iu3qez/hbr-8b/schematic/converted/bfo.kicad_sch

## KiCad design schematic/converted/bfo.kicad_sch (2026-09-16)

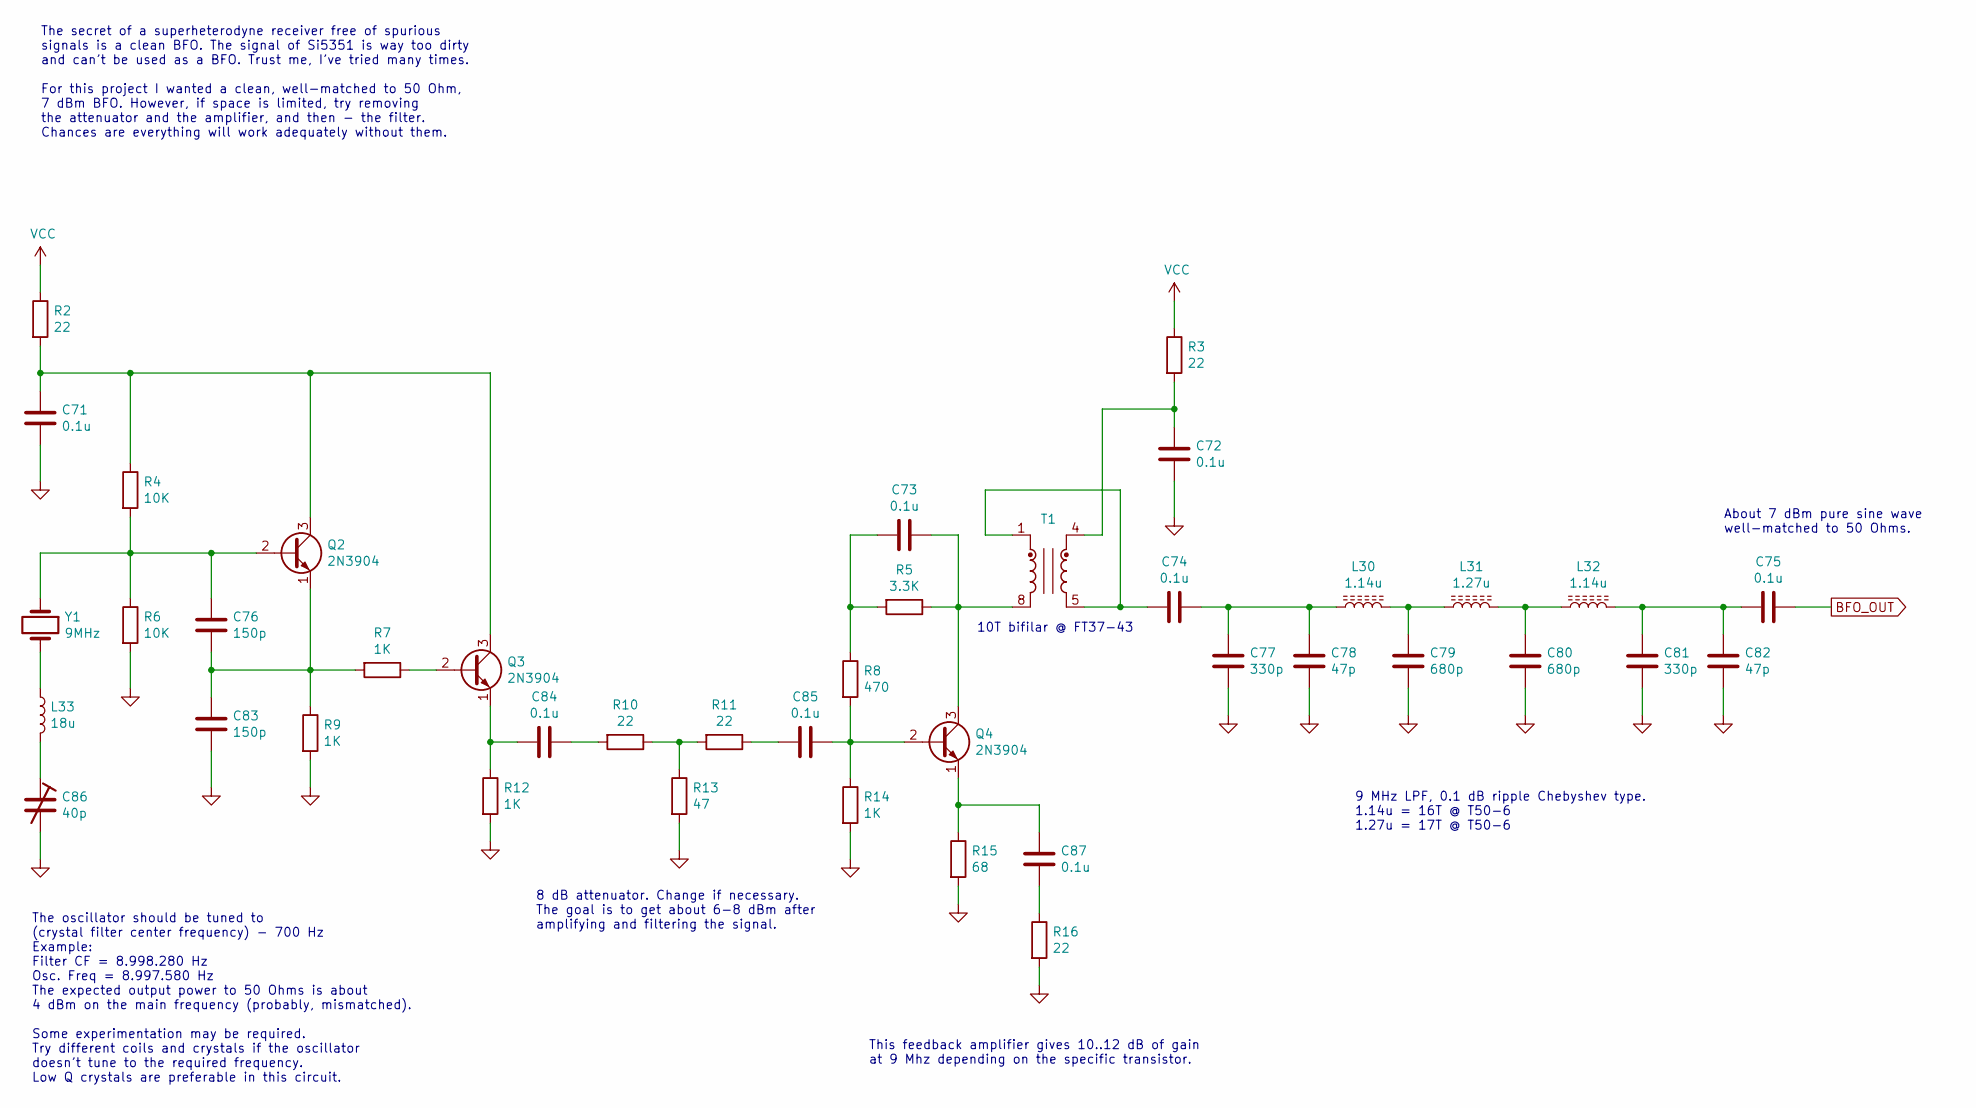
[picture p1: schematic bfo.kicad_sch]

Parts:
C71, C72, C73, C74, C75, C84, C85, C87: 0.1u
C76, C83: 150p
C77, C81: 330p
C78, C82: 47p
C79, C80: 680p
C86: 40p
L30, L32: 1.14u
L31: 1.27u
L33: 18u
Q2, Q3, Q4: 2N3904; TO-92_Inline
R2, R3, R10, R11, R16: 22
R4, R6: 10K
R5: 3.3K
R7, R9, R12, R14: 1K
R8: 470
R13: 47
R15: 68
T1: FT37-43; Pulse_PA2007NL
Y1: 9MHz

Connections:
BFO_OUT: C75.1
GND: C71.2, C72.2, C77.2, C78.2, C79.2, C80.2, C81.2, C82.2, C83.2, C86.2, R6.2, R9.2, R12.2, R13.2, R14.2, R15.2, R16.2
unnamed: C71.1, Q2.3 (C), Q3.3 (C), R2.2, R4.1
unnamed: C72.1, R3.2, T1.4
unnamed: C73.1, Q4.3 (C), R5.1, T1.8
unnamed: C73.2, R5.2, R8.1
unnamed: C74.1, C77.1, C78.1, L30.1
unnamed: C74.2, T1.1, T1.5
unnamed: C75.2, C81.1, C82.1, L32.2
unnamed: C76.1, Q2.2 (B), R4.2, R6.1, Y1.1
unnamed: C76.2, C83.1, Q2.1 (E), R7.2, R9.1
unnamed: C79.1, L30.2, L31.1
unnamed: C80.1, L31.2, L32.1
unnamed: C84.1, R10.2
unnamed: C84.2, Q3.1 (E), R12.1
unnamed: C85.1, Q4.2 (B), R8.2, R14.1
unnamed: C85.2, R11.1
unnamed: C86.1, L33.2
unnamed: C87.1, Q4.1 (E), R15.1
unnamed: C87.2, R16.1
unnamed: L33.1, Y1.2
unnamed: Q3.2 (B), R7.1
unnamed: R10.1, R11.2, R13.1
VCC: R2.1, R3.1

Notes on the sheet:
The oscillator should be tuned to (crystal filter center frequency) - 700 Hz Example: Filter CF = 8.998.280 Hz Osc. Freq = 8.997.580 Hz The expected output power to 50 Ohms is about 4 dBm on the main frequency (probably, mismatched). Some experimentation may be required. Try different coils and cry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
This feedback amplifier gives 10..12 dB of gain at 9 Mhz depending on the specific transistor.
8 dB attenuator. Change if necessary. The goal is to get about 6-8 dBm after amplifying and filtering the signal.
The secret of a superheterodyne receiver free of spurious signals is a clean BFO. The signal of Si5351 is way too dirty and can’t be used as a BFO. Trust me, I’ve tried many times. For this project I wanted a clean, well-matched to 50 Ohm, 7 dBm BFO. However, if space is limited, try removing the a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
About 7 dBm pure sine wave well-matched to 50 Ohms.
9 MHz LPF, 0.1 dB ripple Chebyshev type. 1.14u = 16T @ T50-6 1.27u = 17T @ T50-6
10T bifilar @ FT37-43
