iu3qez/hbr-8b/schematic/converted/bpf-relays-1.kicad_sch

## KiCad design schematic/converted/bpf-relays-1.kicad_sch (2026-09-16)

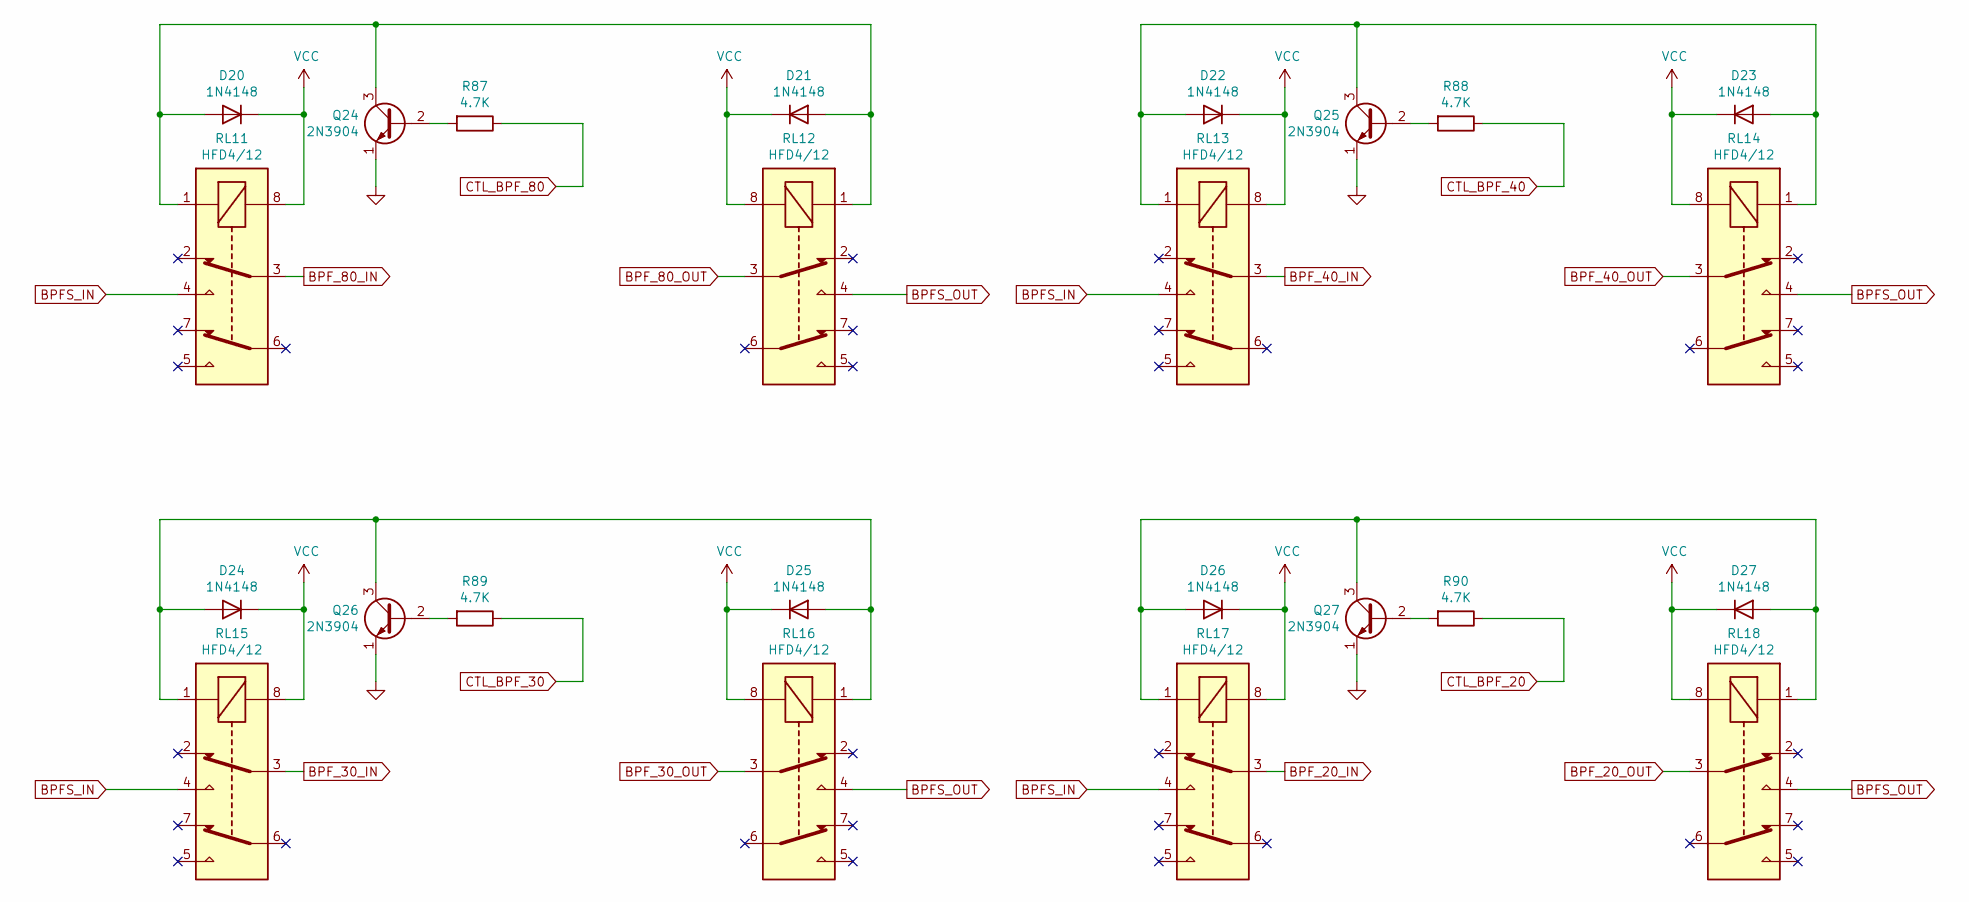
[picture p2: schematic bpf-relays-1.kicad_sch]

Parts:
D20, D21, D22, D23, D24, D25, D26, D27: 1N4148; D_DO-41_SOD81_P10.16mm_Horizontal
Q24, Q25, Q26, Q27: 2N3904; TO-92_Inline
R87, R88, R89, R90: 4.7K
RL11, RL12, RL13, RL14, RL15, RL16, RL17, RL18: HFD4/12; Relay_DPDT_Omron_G2RL

Connections:
BPFS_IN: RL11.4, RL13.4, RL15.4, RL17.4
BPFS_OUT: RL12.4, RL14.4, RL16.4, RL18.4
BPF_20_IN: RL17.3
BPF_20_OUT: RL18.3
BPF_30_IN: RL15.3
BPF_30_OUT: RL16.3
BPF_40_IN: RL13.3
BPF_40_OUT: RL14.3
BPF_80_IN: RL11.3
BPF_80_OUT: RL12.3
CTL_BPF_20: R90.1
CTL_BPF_30: R89.1
CTL_BPF_40: R88.1
CTL_BPF_80: R87.1
GND: Q24.1 (E), Q25.1 (E), Q26.1 (E), Q27.1 (E)
unnamed: D20.2 (A), D21.2 (A), Q24.3 (C), RL11.1, RL12.1
unnamed: D22.2 (A), D23.2 (A), Q25.3 (C), RL13.1, RL14.1
unnamed: D24.2 (A), D25.2 (A), Q26.3 (C), RL15.1, RL16.1
unnamed: D26.2 (A), D27.2 (A), Q27.3 (C), RL17.1, RL18.1
unnamed: Q24.2 (B), R87.2
unnamed: Q25.2 (B), R88.2
unnamed: Q26.2 (B), R89.2
unnamed: Q27.2 (B), R90.2
VCC: D20.1 (K), D21.1 (K), D22.1 (K), D23.1 (K), D24.1 (K), D25.1 (K), D26.1 (K), D27.1 (K), RL11.8, RL12.8, RL13.8, RL14.8, RL15.8, RL16.8, RL17.8, RL18.8
