iu3qez/hbr-8b/schematic/converted/bpf-relays-2.kicad_sch

## KiCad design schematic/converted/bpf-relays-2.kicad_sch (2026-09-16)

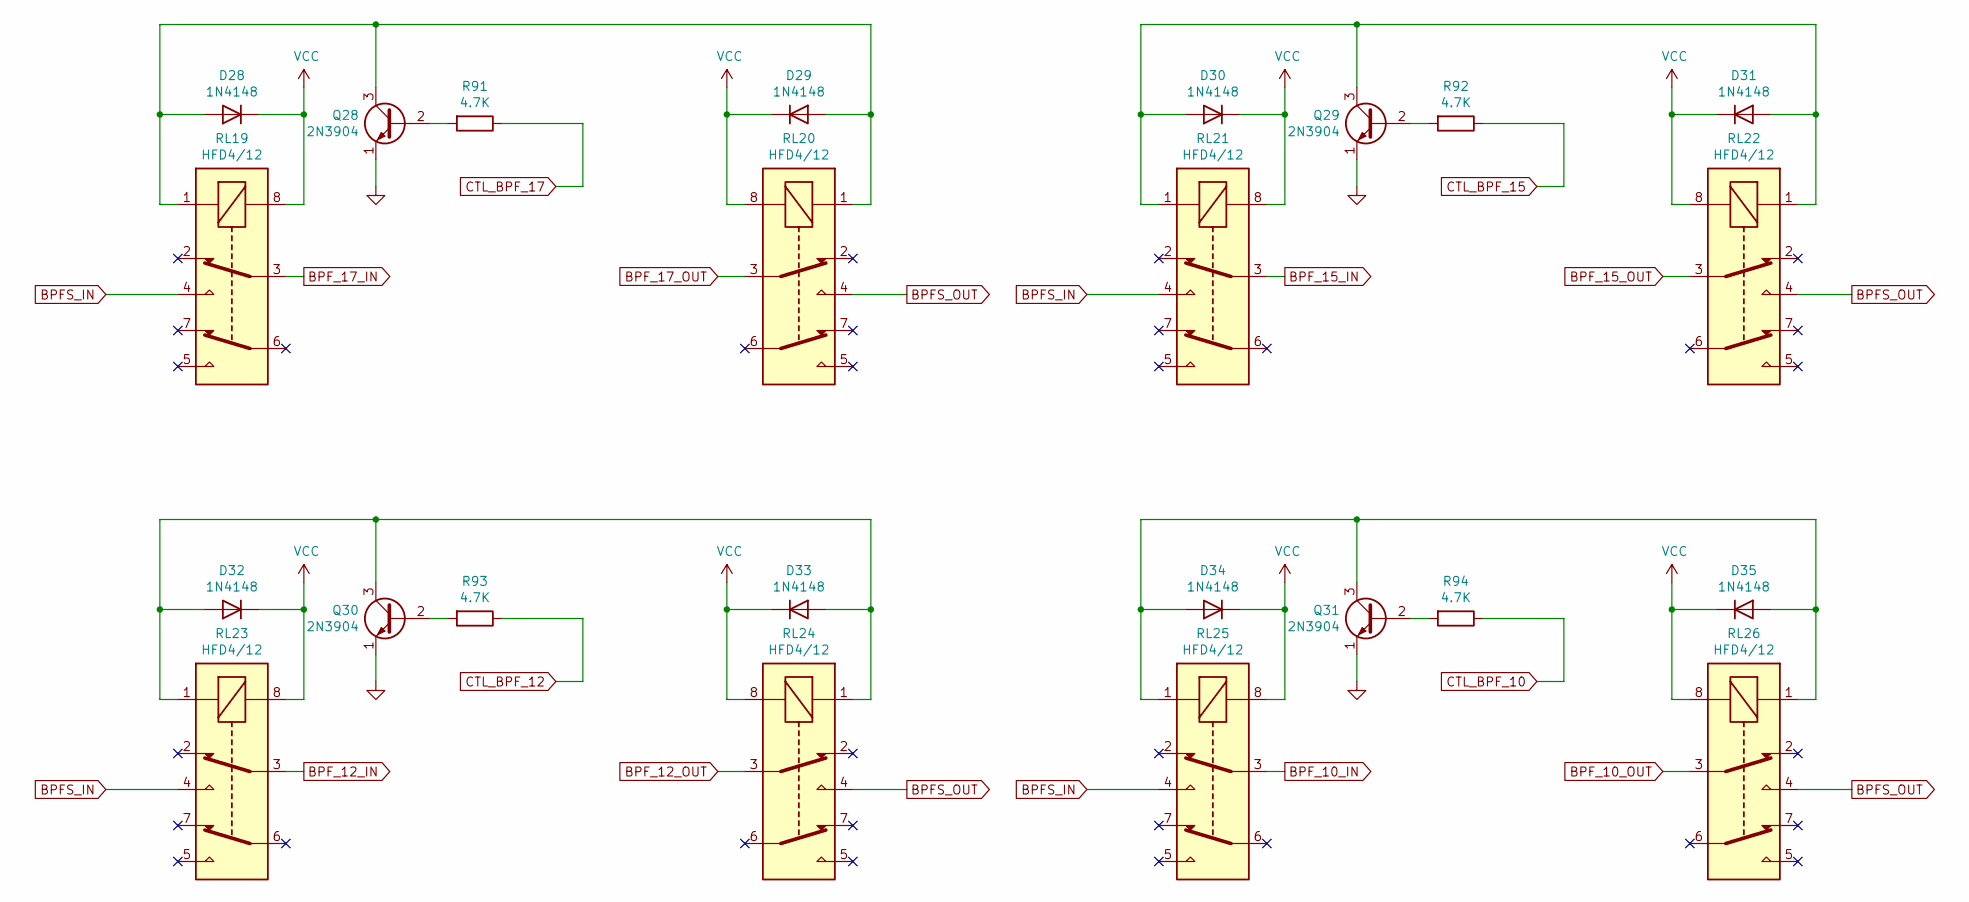
[picture p3: schematic bpf-relays-2.kicad_sch]

Parts:
D28, D29, D30, D31, D32, D33, D34, D35: 1N4148; D_DO-41_SOD81_P10.16mm_Horizontal
Q28, Q29, Q30, Q31: 2N3904; TO-92_Inline
R91, R92, R93, R94: 4.7K
RL19, RL20, RL21, RL22, RL23, RL24, RL25, RL26: HFD4/12; Relay_DPDT_Omron_G2RL

Connections:
BPFS_IN: RL19.4, RL21.4, RL23.4, RL25.4
BPFS_OUT: RL20.4, RL22.4, RL24.4, RL26.4
BPF_10_IN: RL25.3
BPF_10_OUT: RL26.3
BPF_12_IN: RL23.3
BPF_12_OUT: RL24.3
BPF_15_IN: RL21.3
BPF_15_OUT: RL22.3
BPF_17_IN: RL19.3
BPF_17_OUT: RL20.3
CTL_BPF_10: R94.1
CTL_BPF_12: R93.1
CTL_BPF_15: R92.1
CTL_BPF_17: R91.1
GND: Q28.1 (E), Q29.1 (E), Q30.1 (E), Q31.1 (E)
unnamed: D28.2 (A), D29.2 (A), Q28.3 (C), RL19.1, RL20.1
unnamed: D30.2 (A), D31.2 (A), Q29.3 (C), RL21.1, RL22.1
unnamed: D32.2 (A), D33.2 (A), Q30.3 (C), RL23.1, RL24.1
unnamed: D34.2 (A), D35.2 (A), Q31.3 (C), RL25.1, RL26.1
unnamed: Q28.2 (B), R91.2
unnamed: Q29.2 (B), R92.2
unnamed: Q30.2 (B), R93.2
unnamed: Q31.2 (B), R94.2
VCC: D28.1 (K), D29.1 (K), D30.1 (K), D31.1 (K), D32.1 (K), D33.1 (K), D34.1 (K), D35.1 (K), RL19.8, RL20.8, RL21.8, RL22.8, RL23.8, RL24.8, RL25.8, RL26.8
