iu3qez/hbr-8b/schematic/converted/bpfs.kicad_sch

## KiCad design schematic/converted/bpfs.kicad_sch (2026-09-16)

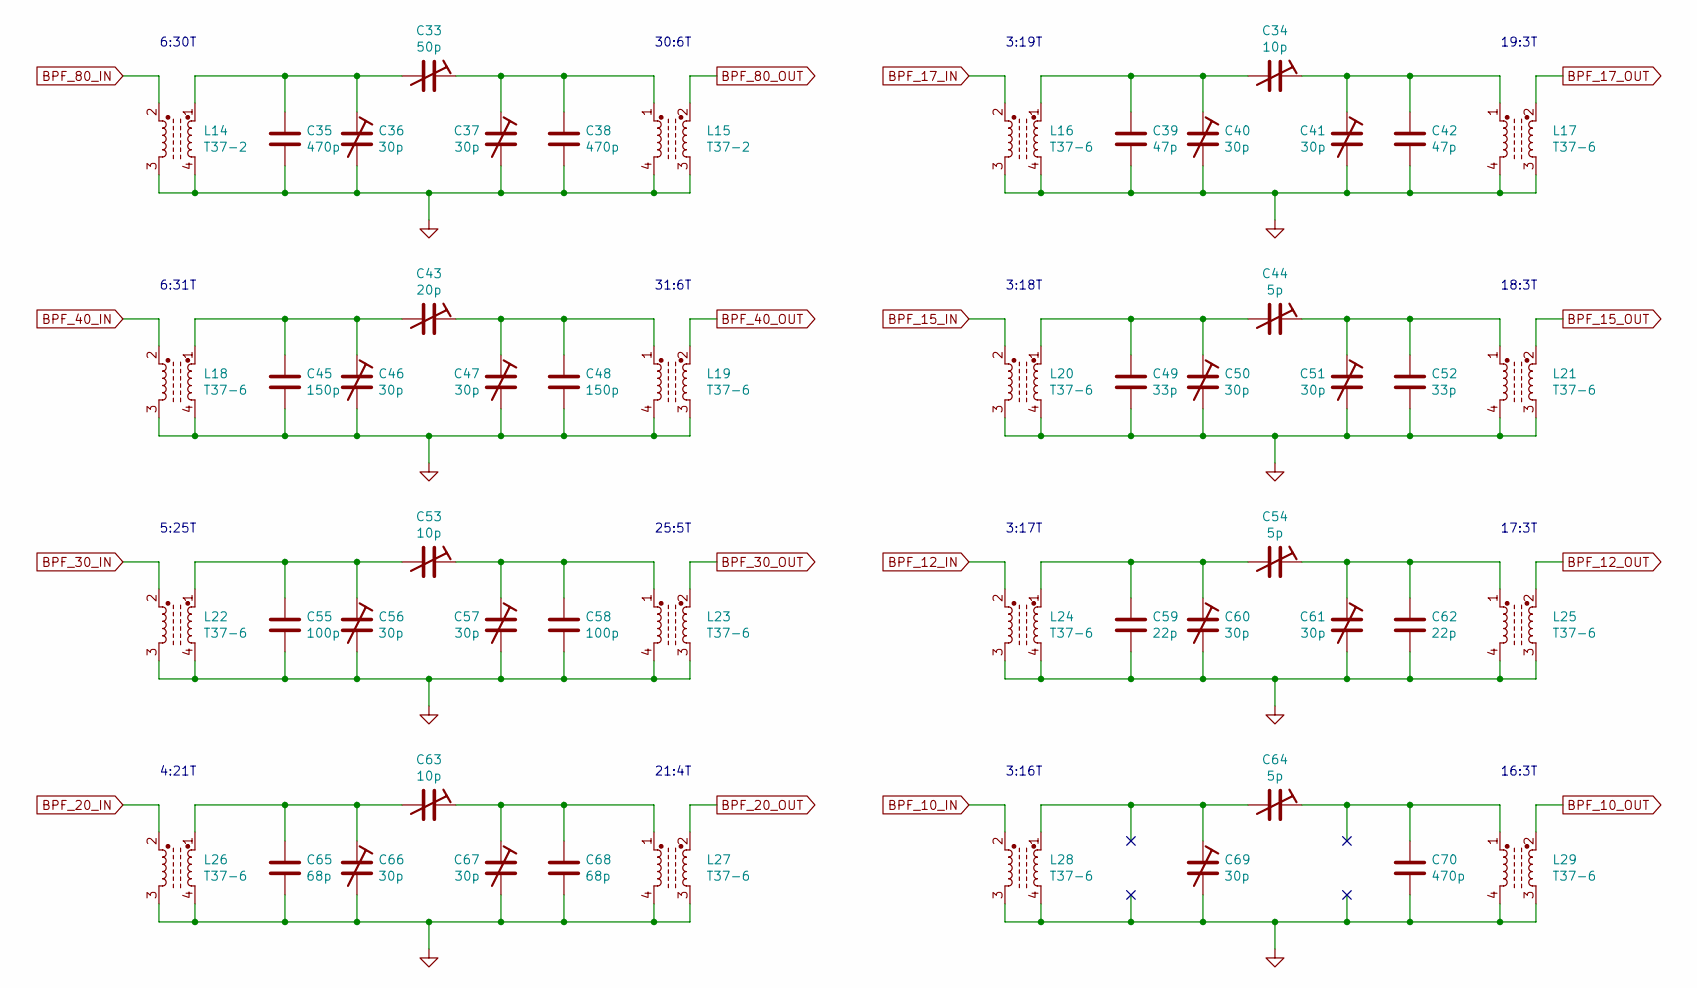
[picture p4: schematic bpfs.kicad_sch]

Parts:
C33: 50p
C34, C53, C63: 10p
C35, C38, C70: 470p
C36, C37, C40, C41, C46, C47, C50, C51, C56, C57, C60, C61, C66, C67, C69: 30p
C39, C42: 47p
C43: 20p
C44, C54, C64: 5p
C45, C48: 150p
C49, C52: 33p
C55, C58: 100p
C59, C62: 22p
C65, C68: 68p
L14, L15: T37-2
L16, L17, L18, L19, L20, L21, L22, L23, L24, L25, L26, L27, L28, L29: T37-6

Connections:
BPF_10_IN: L28.2
BPF_10_OUT: L29.2
BPF_12_IN: L24.2
BPF_12_OUT: L25.2
BPF_15_IN: L20.2
BPF_15_OUT: L21.2
BPF_17_IN: L16.2
BPF_17_OUT: L17.2
BPF_20_IN: L26.2
BPF_20_OUT: L27.2
BPF_30_IN: L22.2
BPF_30_OUT: L23.2
BPF_40_IN: L18.2
BPF_40_OUT: L19.2
BPF_80_IN: L14.2
BPF_80_OUT: L15.2
GND: C35.2, C36.2, C37.2, C38.2, C39.2, C40.2, C41.2, C42.2, C45.2, C46.2, C47.2, C48.2, C49.2, C50.2, C51.2, C52.2, C55.2, C56.2, C57.2, C58.2, C59.2, C60.2, C61.2, C62.2, C65.2, C66.2, C67.2, C68.2, C69.2, C70.2, L14.3, L14.4, L15.3, L15.4, L16.3, L16.4, L17.3, L17.4, L18.3, L18.4, L19.3, L19.4, L20.3, L20.4, L21.3, L21.4, L22.3, L22.4, L23.3, L23.4, L24.3, L24.4, L25.3, L25.4, L26.3, L26.4, L27.3, L27.4, L28.3, L28.4, L29.3, L29.4
unnamed: C33.1, C37.1, C38.1, L15.1
unnamed: C33.2, C35.1, C36.1, L14.1
unnamed: C34.1, C41.1, C42.1, L17.1
unnamed: C34.2, C39.1, C40.1, L16.1
unnamed: C43.1, C47.1, C48.1, L19.1
unnamed: C43.2, C45.1, C46.1, L18.1
unnamed: C44.1, C51.1, C52.1, L21.1
unnamed: C44.2, C49.1, C50.1, L20.1
unnamed: C53.1, C57.1, C58.1, L23.1
unnamed: C53.2, C55.1, C56.1, L22.1
unnamed: C54.1, C61.1, C62.1, L25.1
unnamed: C54.2, C59.1, C60.1, L24.1
unnamed: C63.1, C67.1, C68.1, L27.1
unnamed: C63.2, C65.1, C66.1, L26.1
unnamed: C64.1, C70.1, L29.1
unnamed: C64.2, C69.1, L28.1

Notes on the sheet:
18:3T
21:4T
30:6T
3:19T
6:30T
3:16T
3:17T
6:31T
17:3T
16:3T
5:25T
25:5T
4:21T
19:3T
3:18T
31:6T
