iu3qez/hbr-8b/schematic/converted/cw-tone.kicad_sch

## KiCad design schematic/converted/cw-tone.kicad_sch (2026-09-16)

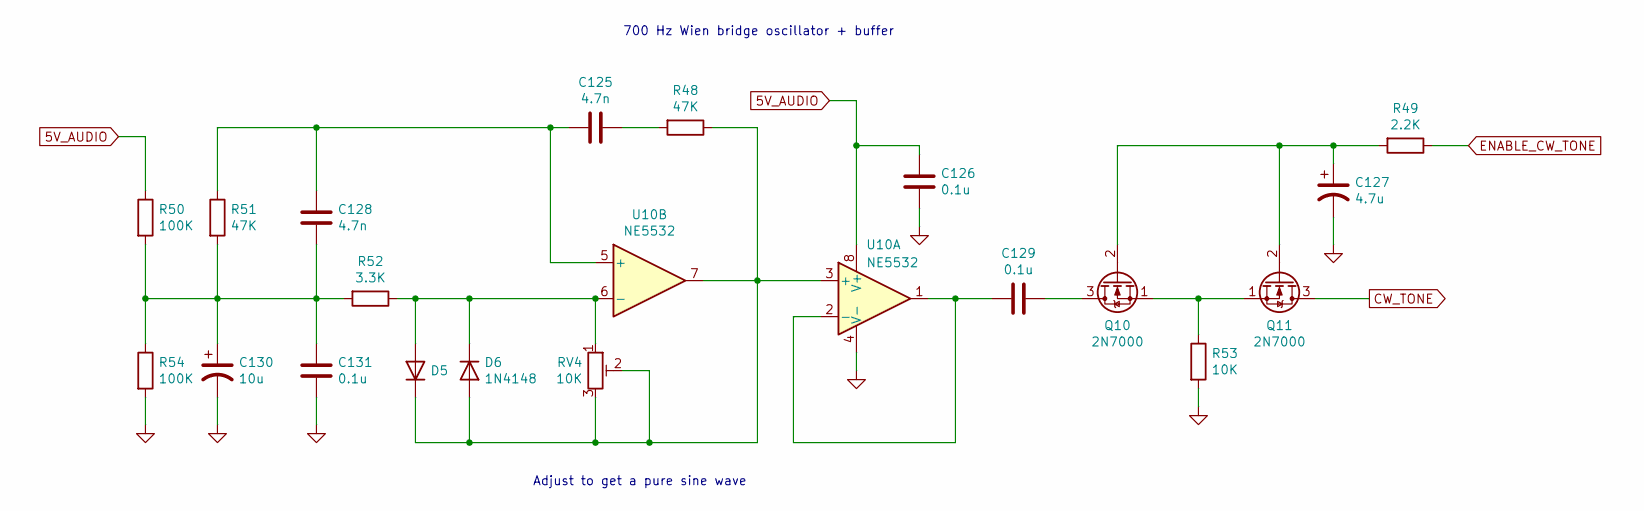
[picture p5: schematic cw-tone.kicad_sch]

Parts:
C125, C128: 4.7n
C126, C129, C131: 0.1u
C127: 4.7u
C130: 10u
D5, D6: 1N4148; D_DO-35_SOD27_P7.62mm_Horizontal
Q10, Q11: 2N7000; TO-92_Inline
R48, R51: 47K
R49: 2.2K
R50, R54: 100K
R52: 3.3K
R53: 10K
RV4: 10K
U10: NE5532

Connections:
5V_AUDIO: C126.1, R50.1, U10.8 (V+)
CW_TONE: Q11.3 (D)
ENABLE_CW_TONE: R49.1
GND: C126.2, C127.2, C130.2, C131.2, R53.2, R54.2, U10.4 (V-)
unnamed: C125.1, R48.2
unnamed: C125.2, C128.1, R51.1, U10.5 (+)
unnamed: C127.1, Q10.2 (G), Q11.2 (G), R49.2
unnamed: C128.2, C130.1, C131.1, R50.2, R51.2, R52.2, R54.1
unnamed: C129.1, Q10.3 (D)
unnamed: C129.2, U10.1, U10.2 (-)
unnamed: D5.1 (K), D6.2 (A), R48.1, RV4.2, RV4.3, U10.3 (+), U10.7
unnamed: D5.2 (A), D6.1 (K), R52.1, RV4.1, U10.6 (-)
unnamed: Q10.1 (S), Q11.1 (S), R53.1

Notes on the sheet:
Adjust to get a pure sine wave
700 Hz Wien bridge oscillator + buffer
