iu3qez/hbr-8b/schematic/converted/extra-rx-filters.kicad_sch

## KiCad design schematic/converted/extra-rx-filters.kicad_sch (2026-09-16)

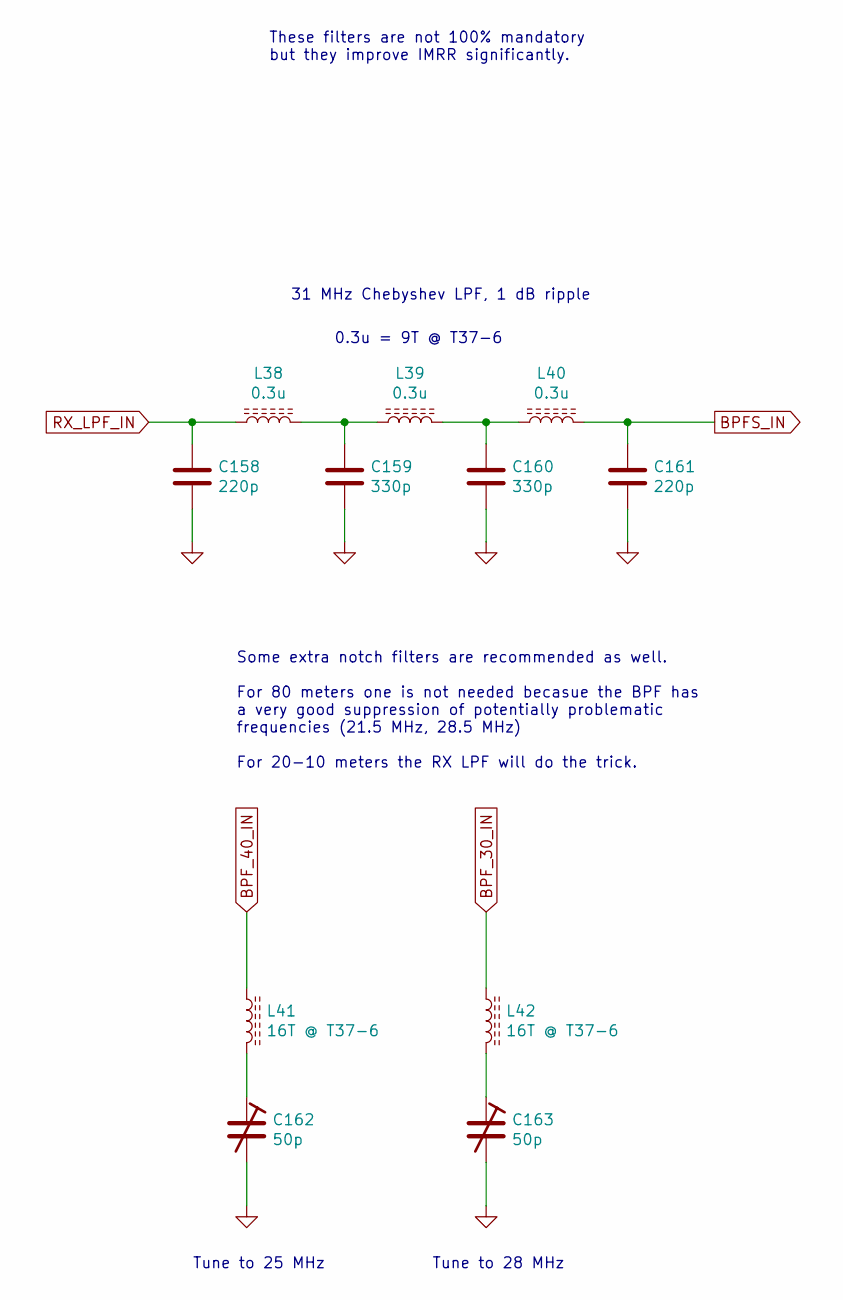
[picture p6: schematic extra-rx-filters.kicad_sch]

Parts:
C158, C161: 220p
C159, C160: 330p
C162, C163: 50p
L38, L39, L40: 0.3u
L41, L42: 16T @ T37-6

Connections:
BPFS_IN: C161.1, L40.2
BPF_30_IN: L42.1
BPF_40_IN: L41.1
GND: C158.2, C159.2, C160.2, C161.2, C162.2, C163.2
unnamed: C159.1, L38.2, L39.1
unnamed: C160.1, L39.2, L40.1
unnamed: C162.1, L41.2
unnamed: C163.1, L42.2
RX_LPF_IN: C158.1, L38.1

Notes on the sheet:
Tune to 28 MHz
These filters are not 100% mandatory but they improve IMRR significantly.
31 MHz Chebyshev LPF, 1 dB ripple
Tune to 25 MHz
Some extra notch filters are recommended as well. For 80 meters one is not needed becasue the BPF has a very good suppression of potentially problematic frequencies (21.5 MHz, 28.5 MHz) For 20-10 meters the RX LPF will do the trick.
0.3u = 9T @ T37-6
