iu3qez/hbr-8b/schematic/converted/hbr-8b.kicad_sch

## KiCad design schematic/converted/hbr-8b.kicad_sch (2026-09-16)

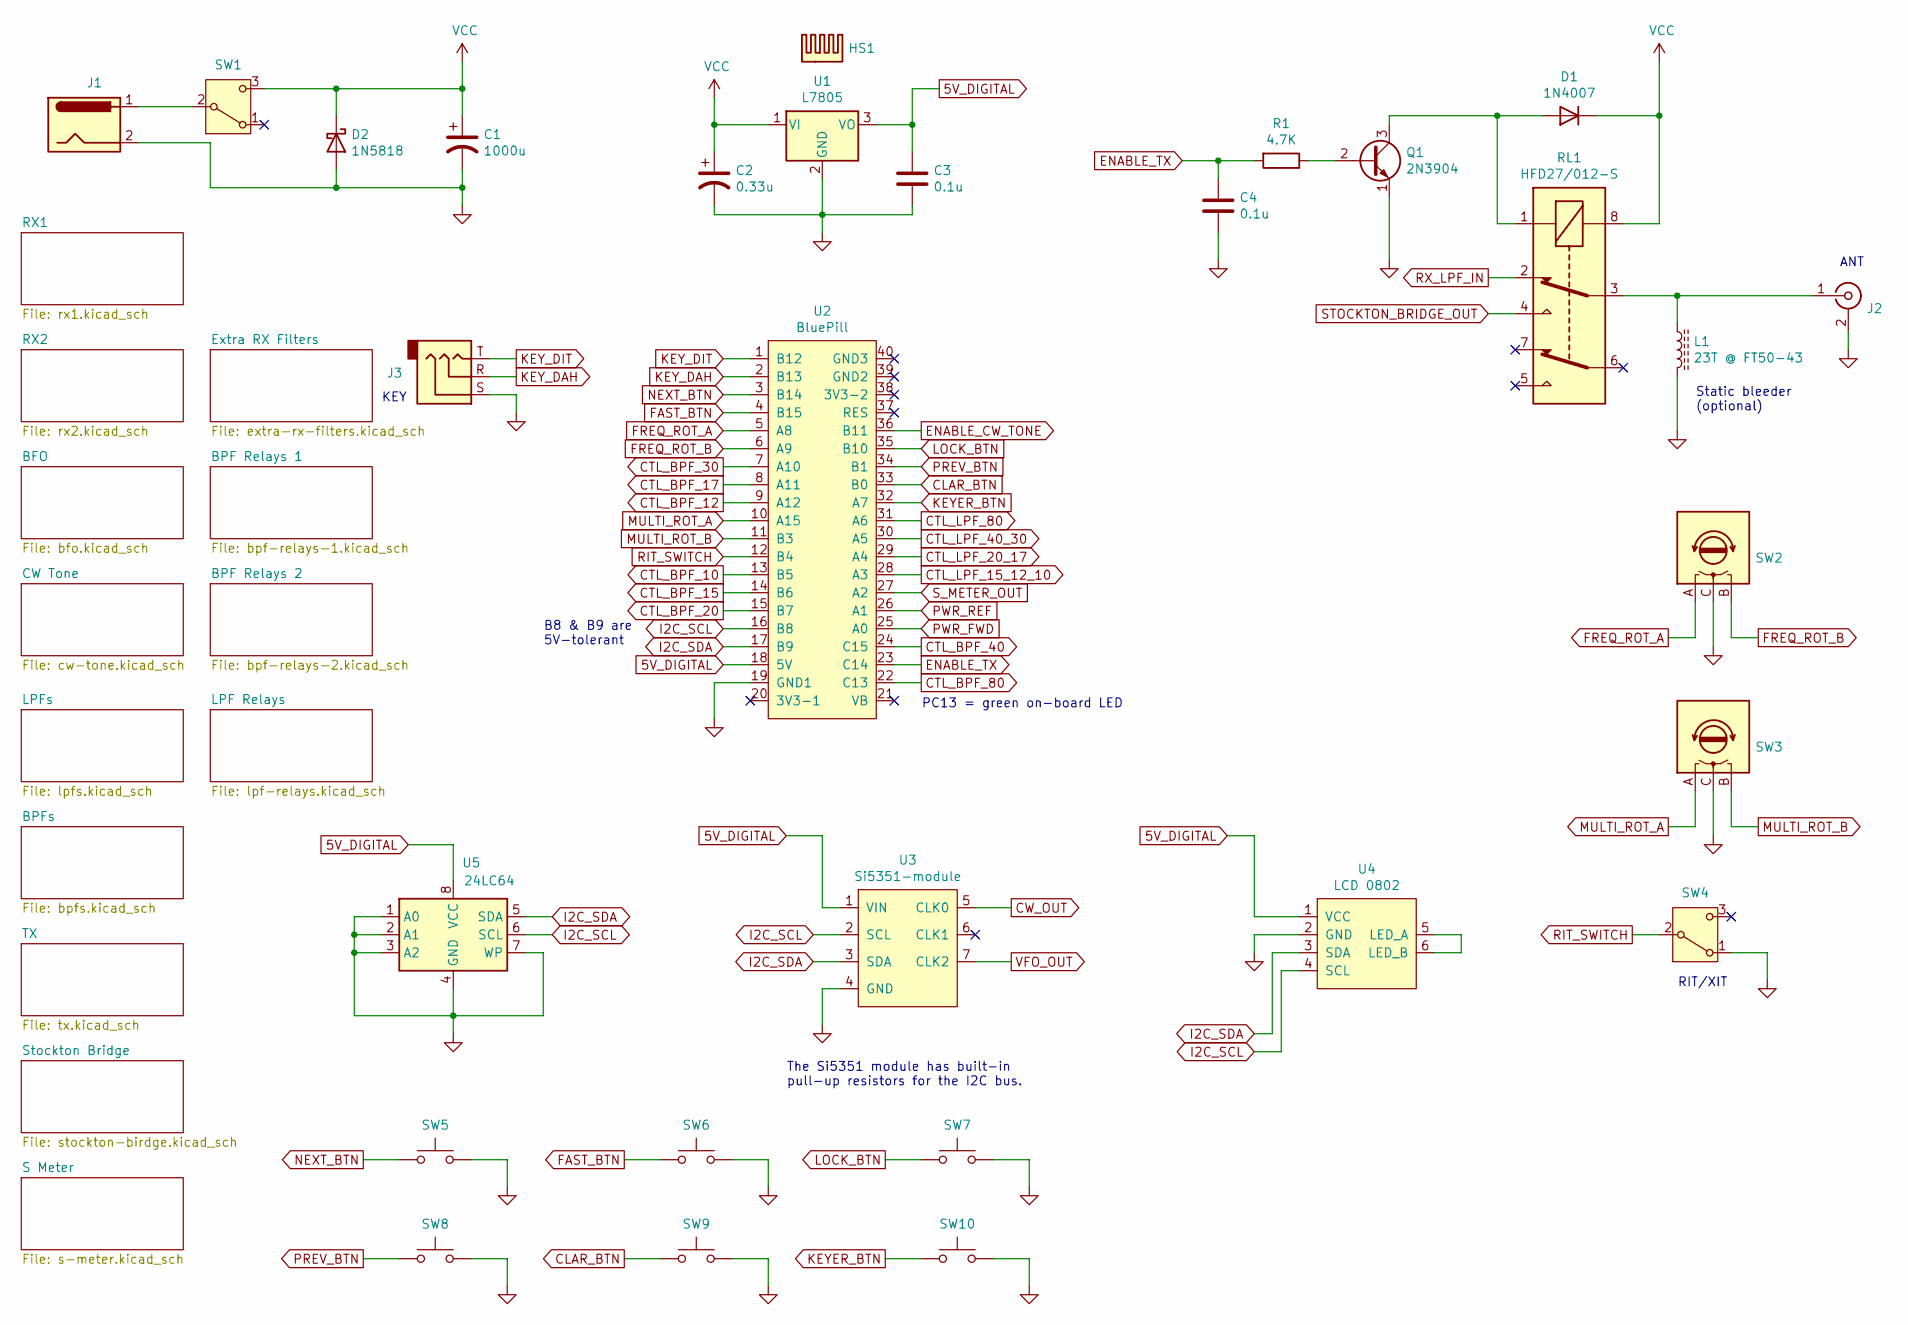
[picture p7: schematic hbr-8b.kicad_sch]

Parts:
C1: 1000u
C2: 0.33u
C3, C4: 0.1u
D1: 1N4007; D_DO-41_SOD81_P10.16mm_Horizontal
D2: 1N5818; D_DO-41_SOD81_P10.16mm_Horizontal
HS1: Heatsink
J1: Barrel_Jack
J2: Conn_Coaxial
J3: AudioJack3
L1: 23T @ FT50-43
Q1: 2N3904; TO-92_Inline
R1: 4.7K
RL1: HFD27/012-S; Relay_DPDT_Omron_G2RL
SW1, SW4: SW_SPDT
SW2, SW3: Rotary_Encoder
SW5, SW6, SW7, SW8, SW9, SW10: SW_Push
U1: L7805; TO-220-3_Vertical
U2: BluePill
U3: Si5351-module
U4: LCD 0802
U5: 24LC64

Connections:
5V_DIGITAL: C3.1, U1.3 (VO), U2.18 (5V), U3.1 (VIN), U4.1 (VCC), U5.8 (VCC)
CLAR_BTN: SW9.1, U2.33 (B0)
CTL_BPF_10: U2.13 (B5)
CTL_BPF_12: U2.9 (A12)
CTL_BPF_15: U2.14 (B6)
CTL_BPF_17: U2.8 (A11)
CTL_BPF_20: U2.15 (B7)
CTL_BPF_30: U2.7 (A10)
CTL_BPF_40: U2.24 (C15)
CTL_BPF_80: U2.22 (C13)
CTL_LPF_15_12_10: U2.28 (A3)
CTL_LPF_20_17: U2.29 (A4)
CTL_LPF_40_30: U2.30 (A5)
CTL_LPF_80: U2.31 (A6)
CW_OUT: U3.5 (CLK0)
ENABLE_CW_TONE: U2.36 (B11)
ENABLE_TX: C4.1, R1.2, U2.23 (C14)
FAST_BTN: SW6.1, U2.4 (B15)
FREQ_ROT_A: SW2.A, U2.5 (A8)
FREQ_ROT_B: SW2.B, U2.6 (A9)
GND: C1.2, C2.2, C3.2, C4.2, D2.2 (A), J1.2, J2.2 (Ext), J3.S, L1.2, Q1.1 (E), SW2.C, SW3.C, SW4.1 (A), SW5.2, SW6.2, SW7.2, SW8.2, SW9.2, SW10.2, U1.2 (GND), U2.19 (GND1), U3.4 (GND), U4.2 (GND), U5.1 (A0), U5.2 (A1), U5.3 (A2), U5.4 (GND), U5.7 (WP)
I2C_SCL: U2.16 (B8), U3.2 (SCL), U4.4 (SCL), U5.6 (SCL)
I2C_SDA: U2.17 (B9), U3.3 (SDA), U4.3 (SDA), U5.5 (SDA)
KEYER_BTN: SW10.1, U2.32 (A7)
KEY_DAH: J3.R, U2.2 (B13)
KEY_DIT: J3.T, U2.1 (B12)
LOCK_BTN: SW7.1, U2.35 (B10)
MULTI_ROT_A: SW3.A, U2.10 (A15)
MULTI_ROT_B: SW3.B, U2.11 (B3)
NEXT_BTN: SW5.1, U2.3 (B14)
unnamed: D1.2 (A), Q1.3 (C), RL1.1
unnamed: J1.1, SW1.2 (B)
unnamed: J2.1 (In), L1.1, RL1.3
unnamed: Q1.2 (B), R1.1
unnamed: U4.5 (LED_A), U4.6 (LED_B)
PREV_BTN: SW8.1, U2.34 (B1)
PWR_FWD: U2.25 (A0)
PWR_REF: U2.26 (A1)
RIT_SWITCH: SW4.2 (B), U2.12 (B4)
RX_LPF_IN: RL1.2
STOCKTON_BRIDGE_OUT: RL1.4
S_METER_OUT: U2.27 (A2)
VCC: C1.1, C2.1, D1.1 (K), D2.1 (K), RL1.8, SW1.3 (C), U1.1 (VI)
VFO_OUT: U3.7 (CLK2)

Notes on the sheet:
B8 & B9 are 5V-tolerant
ANT
RIT/XIT
KEY
The Si5351 module has built-in pull-up resistors for the I2C bus.
PC13 = green on-board LED
Static bleeder (optional)
