iu3qez/hbr-8b/schematic/converted/lpf-relays.kicad_sch

## KiCad design schematic/converted/lpf-relays.kicad_sch (2026-09-16)

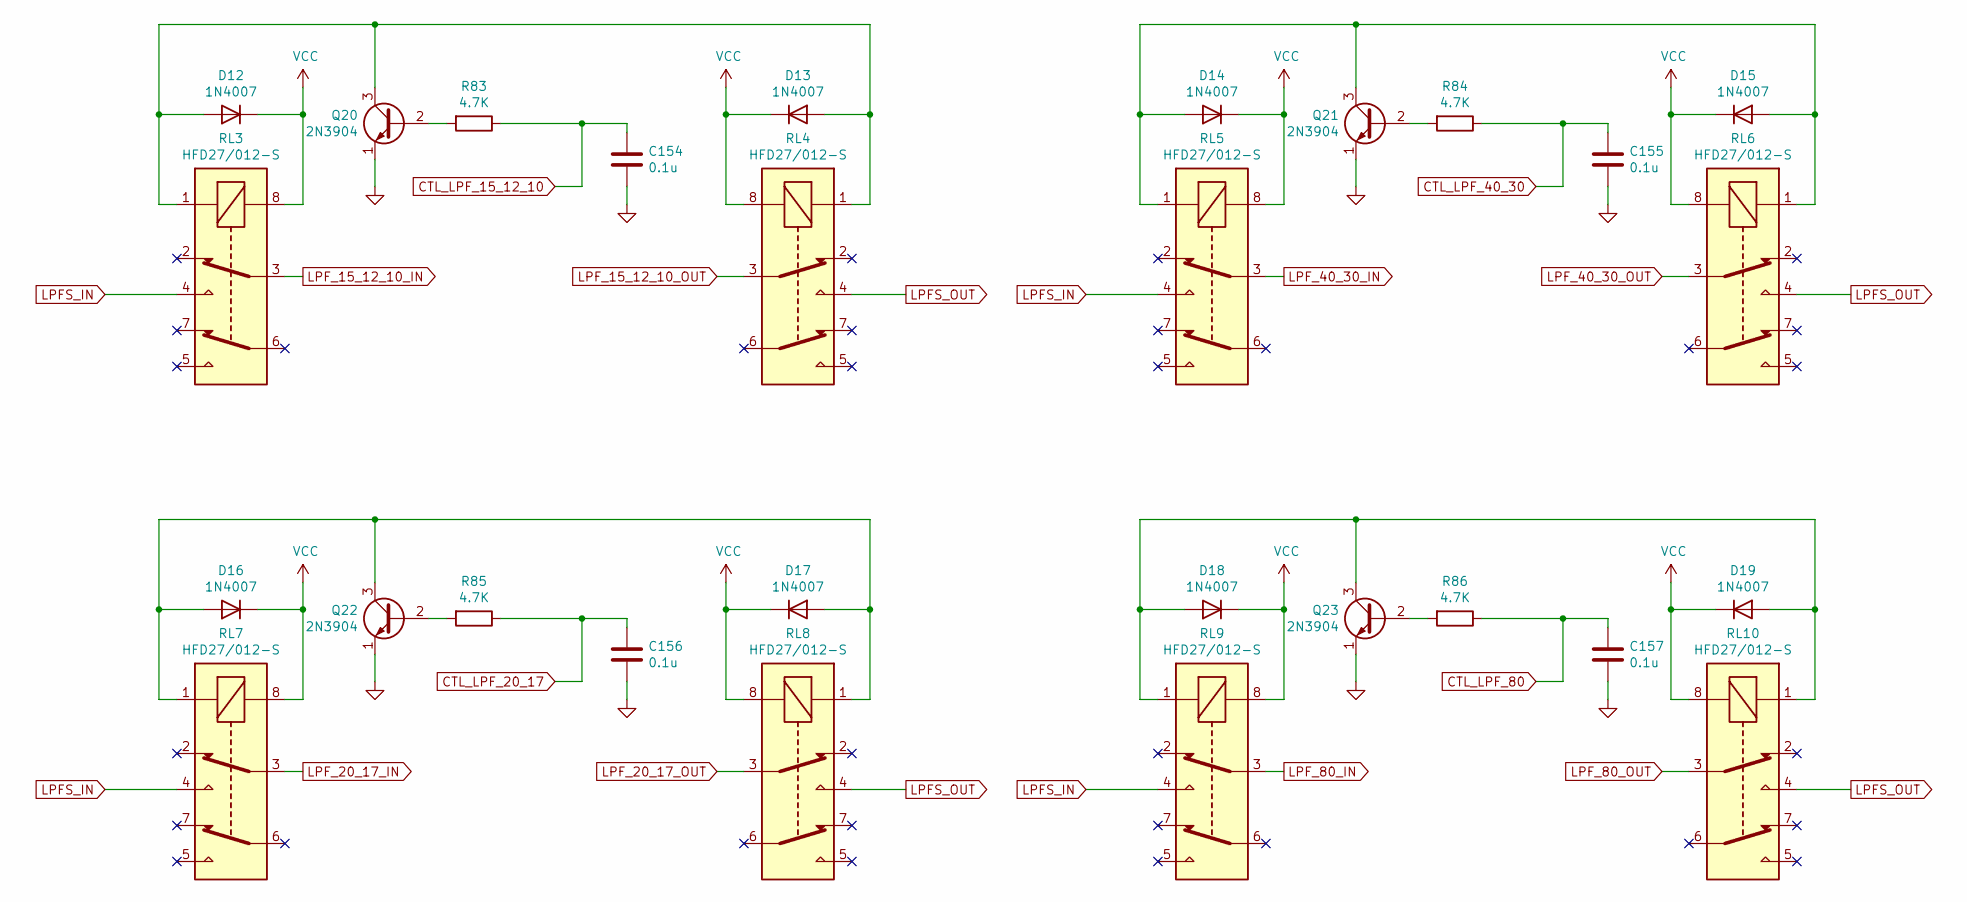
[picture p8: schematic lpf-relays.kicad_sch]

Parts:
C154, C155, C156, C157: 0.1u
D12, D13, D14, D15, D16, D17, D18, D19: 1N4007; D_DO-41_SOD81_P10.16mm_Horizontal
Q20, Q21, Q22, Q23: 2N3904; TO-92_Inline
R83, R84, R85, R86: 4.7K
RL3, RL4, RL5, RL6, RL7, RL8, RL9, RL10: HFD27/012-S; Relay_DPDT_Omron_G2RL

Connections:
CTL_LPF_15_12_10: C154.1, R83.1
CTL_LPF_20_17: C156.1, R85.1
CTL_LPF_40_30: C155.1, R84.1
CTL_LPF_80: C157.1, R86.1
GND: C154.2, C155.2, C156.2, C157.2, Q20.1 (E), Q21.1 (E), Q22.1 (E), Q23.1 (E)
LPFS_IN: RL3.4, RL5.4, RL7.4, RL9.4
LPFS_OUT: RL4.4, RL6.4, RL8.4, RL10.4
LPF_15_12_10_IN: RL3.3
LPF_15_12_10_OUT: RL4.3
LPF_20_17_IN: RL7.3
LPF_20_17_OUT: RL8.3
LPF_40_30_IN: RL5.3
LPF_40_30_OUT: RL6.3
LPF_80_IN: RL9.3
LPF_80_OUT: RL10.3
unnamed: D12.2 (A), D13.2 (A), Q20.3 (C), RL3.1, RL4.1
unnamed: D14.2 (A), D15.2 (A), Q21.3 (C), RL5.1, RL6.1
unnamed: D16.2 (A), D17.2 (A), Q22.3 (C), RL7.1, RL8.1
unnamed: D18.2 (A), D19.2 (A), Q23.3 (C), RL9.1, RL10.1
unnamed: Q20.2 (B), R83.2
unnamed: Q21.2 (B), R84.2
unnamed: Q22.2 (B), R85.2
unnamed: Q23.2 (B), R86.2
VCC: D12.1 (K), D13.1 (K), D14.1 (K), D15.1 (K), D16.1 (K), D17.1 (K), D18.1 (K), D19.1 (K), RL3.8, RL4.8, RL5.8, RL6.8, RL7.8, RL8.8, RL9.8, RL10.8
