iu3qez/hbr-8b/schematic/converted/lpfs.kicad_sch

## KiCad design schematic/converted/lpfs.kicad_sch (2026-09-16)

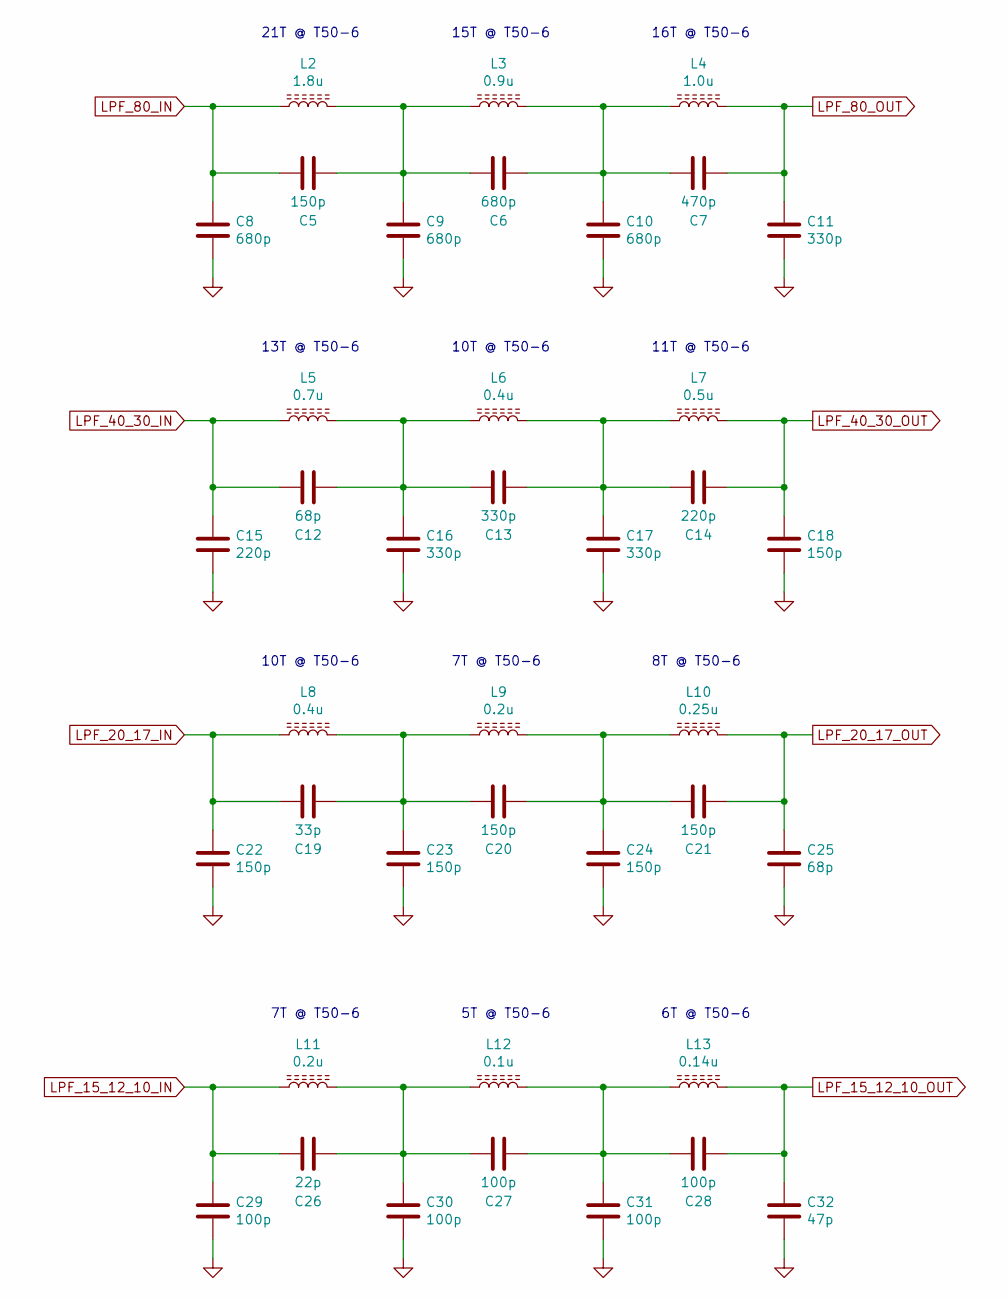
[picture p9: schematic lpfs.kicad_sch]

Parts:
C5, C18, C20, C21, C22, C23, C24: 150p
C6, C8, C9, C10: 680p
C7: 470p
C11, C13, C16, C17: 330p
C12, C25: 68p
C14, C15: 220p
C19: 33p
C26: 22p
C27, C28, C29, C30, C31: 100p
C32: 47p
L2: 1.8u
L3: 0.9u
L4: 1.0u
L5: 0.7u
L6, L8: 0.4u
L7: 0.5u
L9, L11: 0.2u
L10: 0.25u
L12: 0.1u
L13: 0.14u

Connections:
GND: C8.2, C9.2, C10.2, C11.2, C15.2, C16.2, C17.2, C18.2, C22.2, C23.2, C24.2, C25.2, C29.2, C30.2, C31.2, C32.2
LPF_15_12_10_IN: C26.2, C29.1, L11.1
LPF_15_12_10_OUT: C28.1, C32.1, L13.2
LPF_20_17_IN: C19.2, C22.1, L8.1
LPF_20_17_OUT: C21.1, C25.1, L10.2
LPF_40_30_IN: C12.2, C15.1, L5.1
LPF_40_30_OUT: C14.1, C18.1, L7.2
LPF_80_IN: C5.2, C8.1, L2.1
LPF_80_OUT: C7.1, C11.1, L4.2
unnamed: C5.1, C6.2, C9.1, L2.2, L3.1
unnamed: C6.1, C7.2, C10.1, L3.2, L4.1
unnamed: C12.1, C13.2, C16.1, L5.2, L6.1
unnamed: C13.1, C14.2, C17.1, L6.2, L7.1
unnamed: C19.1, C20.2, C23.1, L8.2, L9.1
unnamed: C20.1, C21.2, C24.1, L9.2, L10.1
unnamed: C26.1, C27.2, C30.1, L11.2, L12.1
unnamed: C27.1, C28.2, C31.1, L12.2, L13.1

Notes on the sheet:
11T @ T50-6
7T @ T50-6
10T @ T50-6
8T @ T50-6
16T @ T50-6
6T @ T50-6
15T @ T50-6
5T @ T50-6
13T @ T50-6
21T @ T50-6
