iu3qez/hbr-8b/schematic/converted/rx1.kicad_sch

## KiCad design schematic/converted/rx1.kicad_sch (2026-09-16)

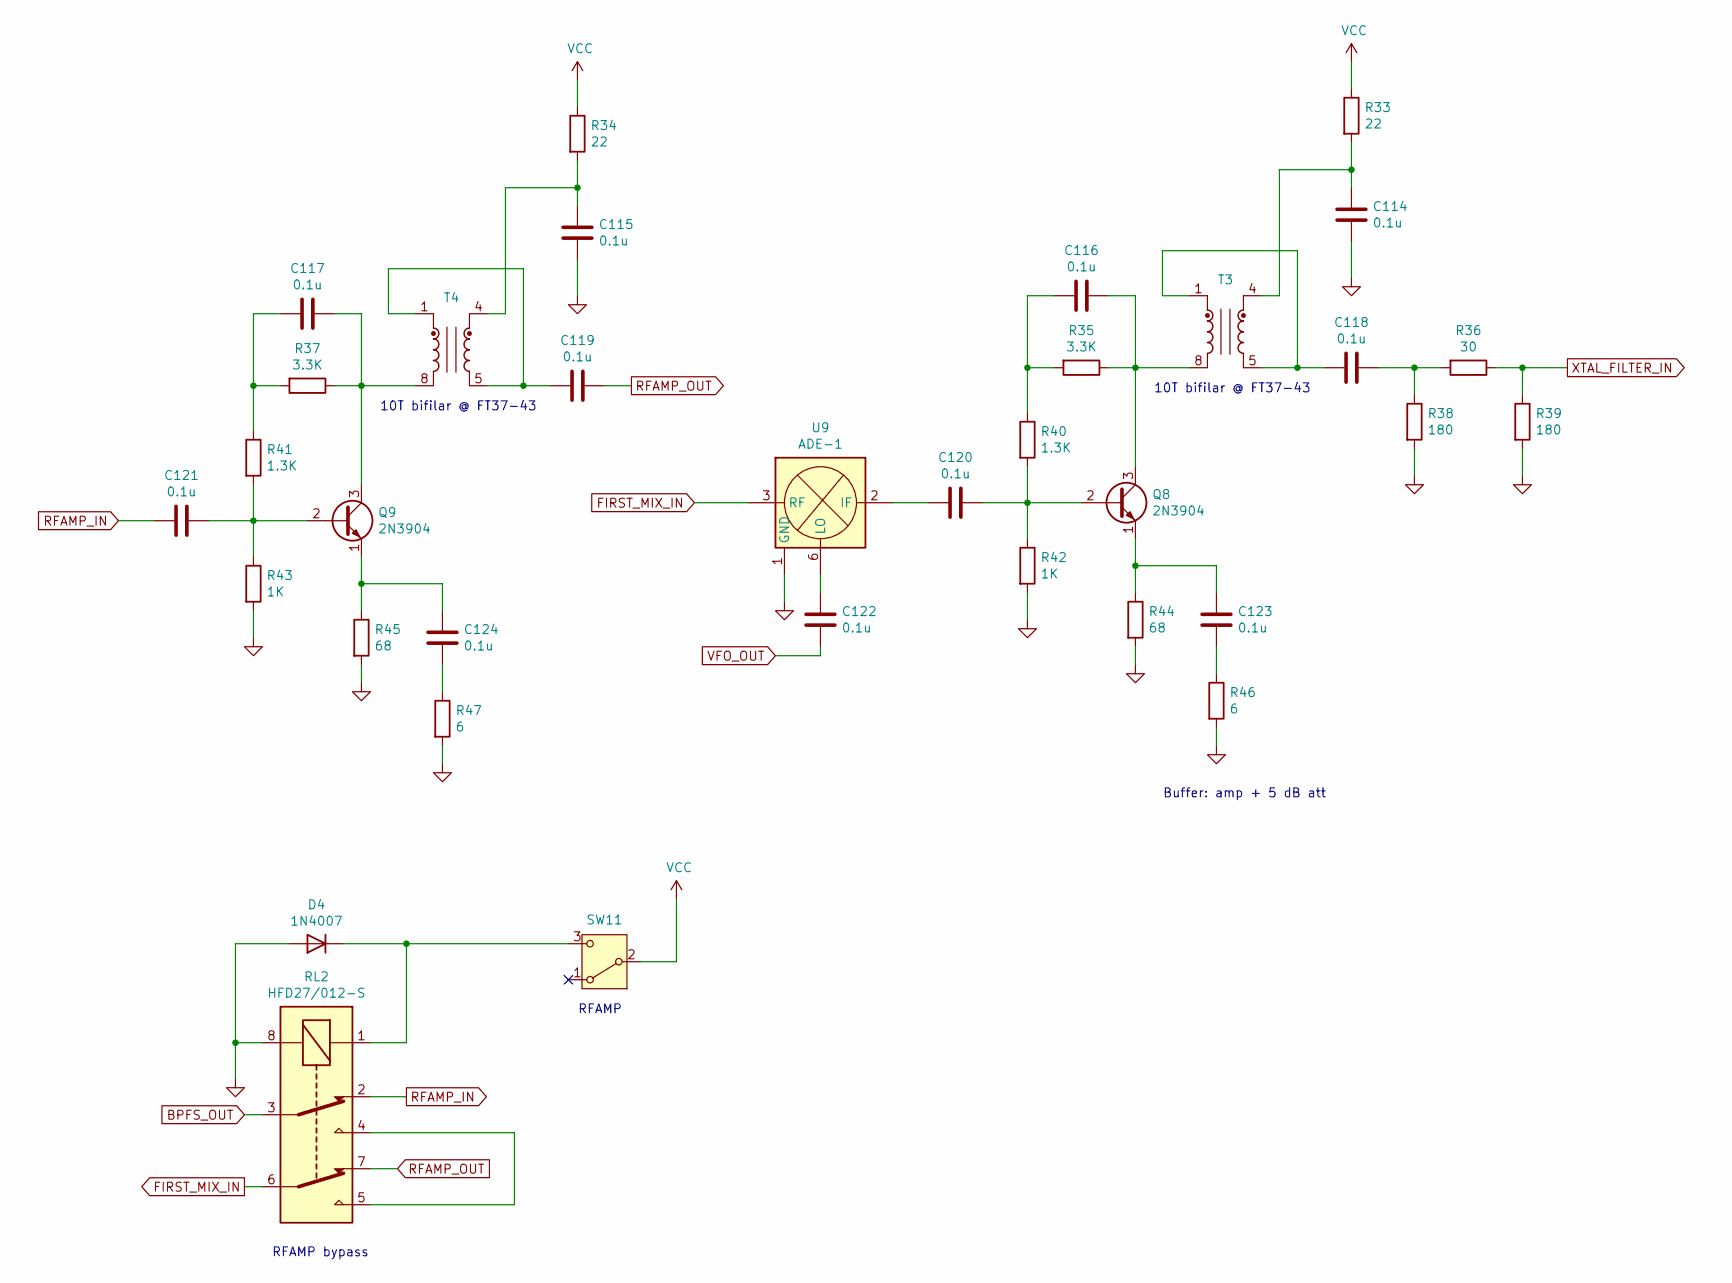
[picture p10: schematic rx1.kicad_sch]

Parts:
C114, C115, C116, C117, C118, C119, C120, C121, C122, C123, C124: 0.1u
D4: 1N4007; D_DO-41_SOD81_P10.16mm_Horizontal
Q8, Q9: 2N3904; TO-92_Inline
R33, R34: 22
R35, R37: 3.3K
R36: 30
R38, R39: 180
R40, R41: 1.3K
R42, R43: 1K
R44, R45: 68
R46, R47: 6
RL2: HFD27/012-S; Relay_DPDT_Omron_G2RL
SW11: SW_SPDT
T3, T4: FT37-43; Pulse_PA2007NL
U9: ADE-1; Mini-Circuits_CD542_LandPatternPL-052

Connections:
BPFS_OUT: RL2.3
FIRST_MIX_IN: RL2.6, U9.3 (RF)
GND: C114.2, C115.2, D4.2 (A), R38.2, R39.2, R42.2, R43.2, R44.2, R45.2, R46.2, R47.2, RL2.8, U9.1 (GND), U9.4 (GND), U9.5 (GND)
unnamed: C114.1, R33.2, T3.4
unnamed: C115.1, R34.2, T4.4
unnamed: C116.1, Q8.3 (C), R35.1, T3.8
unnamed: C116.2, R35.2, R40.1
unnamed: C117.1, Q9.3 (C), R37.1, T4.8
unnamed: C117.2, R37.2, R41.1
unnamed: C118.1, R36.2, R38.1
unnamed: C118.2, T3.1, T3.5
unnamed: C119.2, T4.1, T4.5
unnamed: C120.1, Q8.2 (B), R40.2, R42.1
unnamed: C120.2, U9.2 (IF)
unnamed: C121.1, Q9.2 (B), R41.2, R43.1
unnamed: C122.1, U9.6 (LO)
unnamed: C123.1, Q8.1 (E), R44.1
unnamed: C123.2, R46.1
unnamed: C124.1, Q9.1 (E), R45.1
unnamed: C124.2, R47.1
unnamed: D4.1 (K), RL2.1, SW11.3 (C)
unnamed: RL2.4, RL2.5
RFAMP_IN: C121.2, RL2.2
RFAMP_OUT: C119.1, RL2.7
VCC: R33.1, R34.1, SW11.2 (B)
VFO_OUT: C122.2
XTAL_FILTER_IN: R36.1, R39.1

Notes on the sheet:
RFAMP bypass
10T bifilar @ FT37-43
Buffer: amp + 5 dB att
RFAMP
