iu3qez/hbr-8b/schematic/converted/rx2.kicad_sch

## KiCad design schematic/converted/rx2.kicad_sch (2026-09-16)

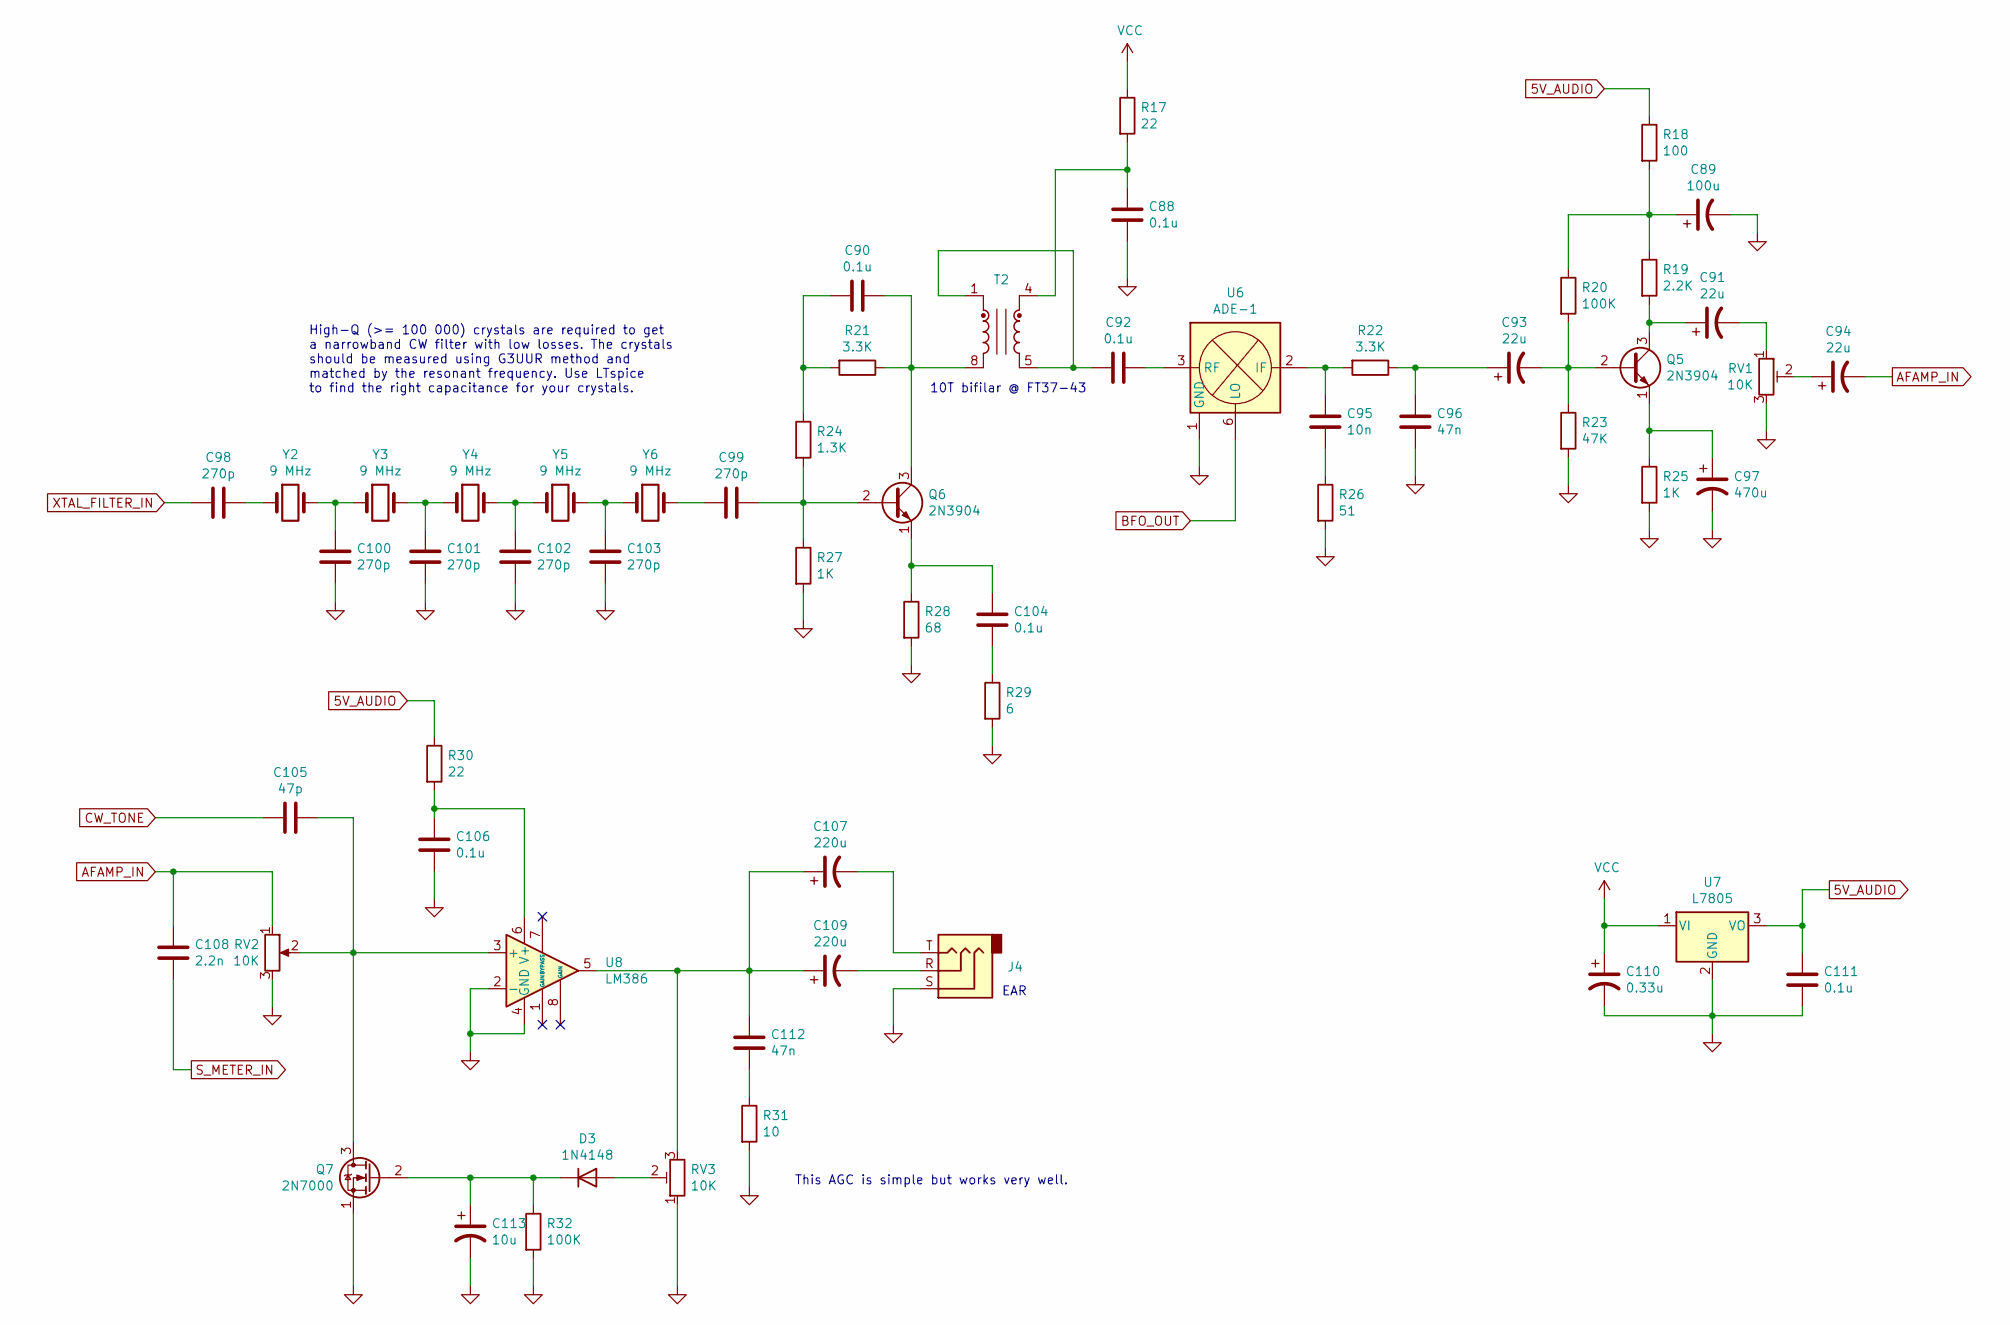
[picture p11: schematic rx2.kicad_sch]

Parts:
C88, C90, C92, C104, C106, C111: 0.1u
C89: 100u
C91, C93, C94: 22u
C95: 10n
C96, C112: 47n
C97: 470u
C98, C99, C100, C101, C102, C103: 270p
C105: 47p
C107, C109: 220u
C108: 2.2n
C110: 0.33u
C113: 10u
D3: 1N4148; D_DO-35_SOD27_P7.62mm_Horizontal
J4: AudioJack3
Q5, Q6: 2N3904; TO-92_Inline
Q7: 2N7000; TO-92_Inline
R17, R30: 22
R18: 100
R19: 2.2K
R20, R32: 100K
R21, R22: 3.3K
R23: 47K
R24: 1.3K
R25, R27: 1K
R26: 51
R28: 68
R29: 6
R31: 10
RV1, RV2, RV3: 10K
T2: FT37-43; Pulse_PA2007NL
U6: ADE-1; Mini-Circuits_CD542_LandPatternPL-052
U7: L7805; TO-220-3_Vertical
U8: LM386
Y2, Y3, Y4, Y5, Y6: 9 MHz

Connections:
5V_AUDIO: C111.1, R18.1, R30.1, U7.3 (VO)
AFAMP_IN: C94.2, C108.1, RV2.1
BFO_OUT: U6.6 (LO)
CW_TONE: C105.2
GND: C88.2, C89.2, C96.2, C97.2, C100.1, C101.1, C102.1, C103.1, C106.1, C110.2, C111.2, C113.2, J4.S, Q7.1 (S), R23.2, R25.2, R26.2, R27.2, R28.2, R29.2, R31.2, R32.2, RV1.3, RV2.3, RV3.1, U6.1 (GND), U6.4 (GND), U6.5 (GND), U7.2 (GND), U8.2 (-), U8.4 (GND)
unnamed: C88.1, R17.2, T2.4
unnamed: C89.1, R18.2, R19.1, R20.1
unnamed: C90.1, Q6.3 (C), R21.1, T2.8
unnamed: C90.2, R21.2, R24.1
unnamed: C91.1, Q5.3 (C), R19.2
unnamed: C91.2, RV1.1
unnamed: C92.1, U6.3 (RF)
unnamed: C92.2, T2.1, T2.5
unnamed: C93.1, C96.1, R22.1
unnamed: C93.2, Q5.2 (B), R20.2, R23.1
unnamed: C94.1, RV1.2
unnamed: C95.1, R22.2, U6.2 (IF)
unnamed: C95.2, R26.1
unnamed: C97.1, Q5.1 (E), R25.1
unnamed: C98.1, Y2.1
unnamed: C99.1, Q6.2 (B), R24.2, R27.1
unnamed: C99.2, Y6.2
unnamed: C100.2, Y2.2, Y3.1
unnamed: C101.2, Y3.2, Y4.1
unnamed: C102.2, Y4.2, Y5.1
unnamed: C103.2, Y5.2, Y6.1
unnamed: C104.1, Q6.1 (E), R28.1
unnamed: C104.2, R29.1
unnamed: C105.1, Q7.3 (D), RV2.2, U8.3 (+)
unnamed: C106.2, R30.2, U8.6 (V+)
unnamed: C107.1, C109.1, C112.2, RV3.3, U8.5
unnamed: C107.2, J4.T
unnamed: C109.2, J4.R
unnamed: C112.1, R31.1
unnamed: C113.1, D3.1 (K), Q7.2 (G), R32.1
unnamed: D3.2 (A), RV3.2
S_METER_IN: C108.2
VCC: C110.1, R17.1, U7.1 (VI)
XTAL_FILTER_IN: C98.2

Notes on the sheet:
High-Q (>= 100 000) crystals are required to get a narrowband CW filter with low losses. The crystals should be measured using G3UUR method and matched by the resonant frequency. Use LTspice to find the right capacitance for your crystals.
This AGC is simple but works very well.
10T bifilar @ FT37-43
EAR
