iu3qez/hbr-8b/schematic/converted/s-meter.kicad_sch

## KiCad design schematic/converted/s-meter.kicad_sch (2026-09-16)

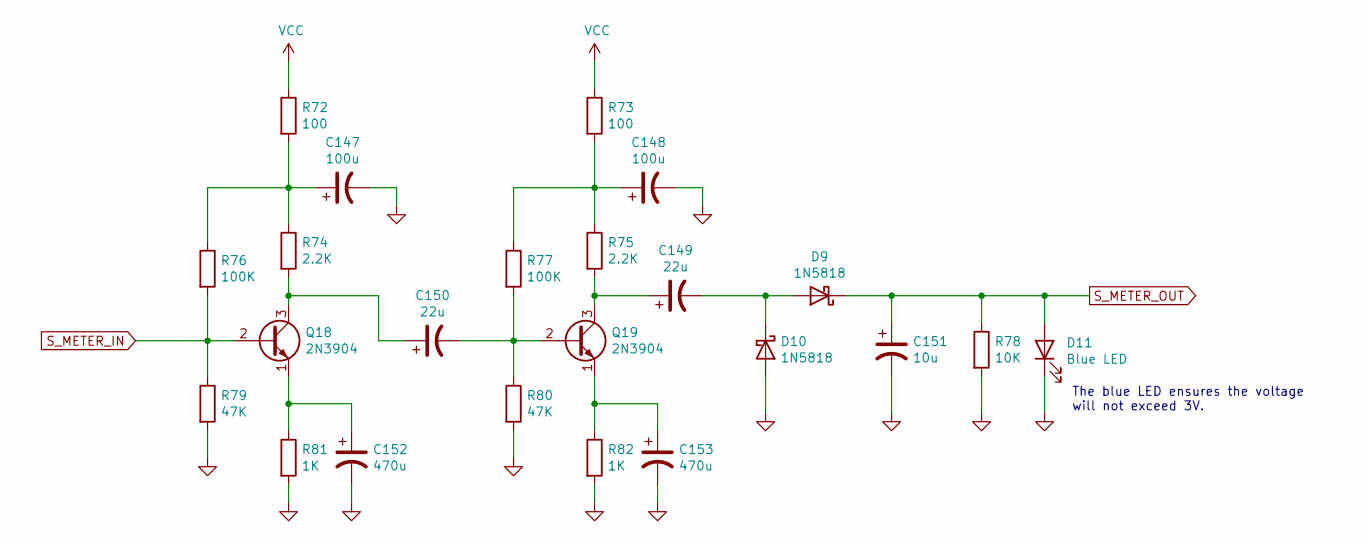
[picture p12: schematic s-meter.kicad_sch]

Parts:
C147, C148: 100u
C149, C150: 22u
C151: 10u
C152, C153: 470u
D9, D10: 1N5818; D_DO-41_SOD81_P10.16mm_Horizontal
D11: Blue LED
Q18, Q19: 2N3904; TO-92_Inline
R72, R73: 100
R74, R75: 2.2K
R76, R77: 100K
R78: 10K
R79, R80: 47K
R81, R82: 1K

Connections:
GND: C147.2, C148.2, C151.2, C152.2, C153.2, D10.2 (A), D11.1 (K), R78.2, R79.2, R80.2, R81.2, R82.2
unnamed: C147.1, R72.2, R74.1, R76.1
unnamed: C148.1, R73.2, R75.1, R77.1
unnamed: C149.1, Q19.3 (C), R75.2
unnamed: C149.2, D9.2 (A), D10.1 (K)
unnamed: C150.1, Q18.3 (C), R74.2
unnamed: C150.2, Q19.2 (B), R77.2, R80.1
unnamed: C152.1, Q18.1 (E), R81.1
unnamed: C153.1, Q19.1 (E), R82.1
S_METER_IN: Q18.2 (B), R76.2, R79.1
S_METER_OUT: C151.1, D9.1 (K), D11.2 (A), R78.1
VCC: R72.1, R73.1

Notes on the sheet:
The blue LED ensures the voltage will not exceed 3V.
