iu3qez/hbr-8b/schematic/converted/stockton-birdge.kicad_sch

## KiCad design schematic/converted/stockton-birdge.kicad_sch (2026-09-16)

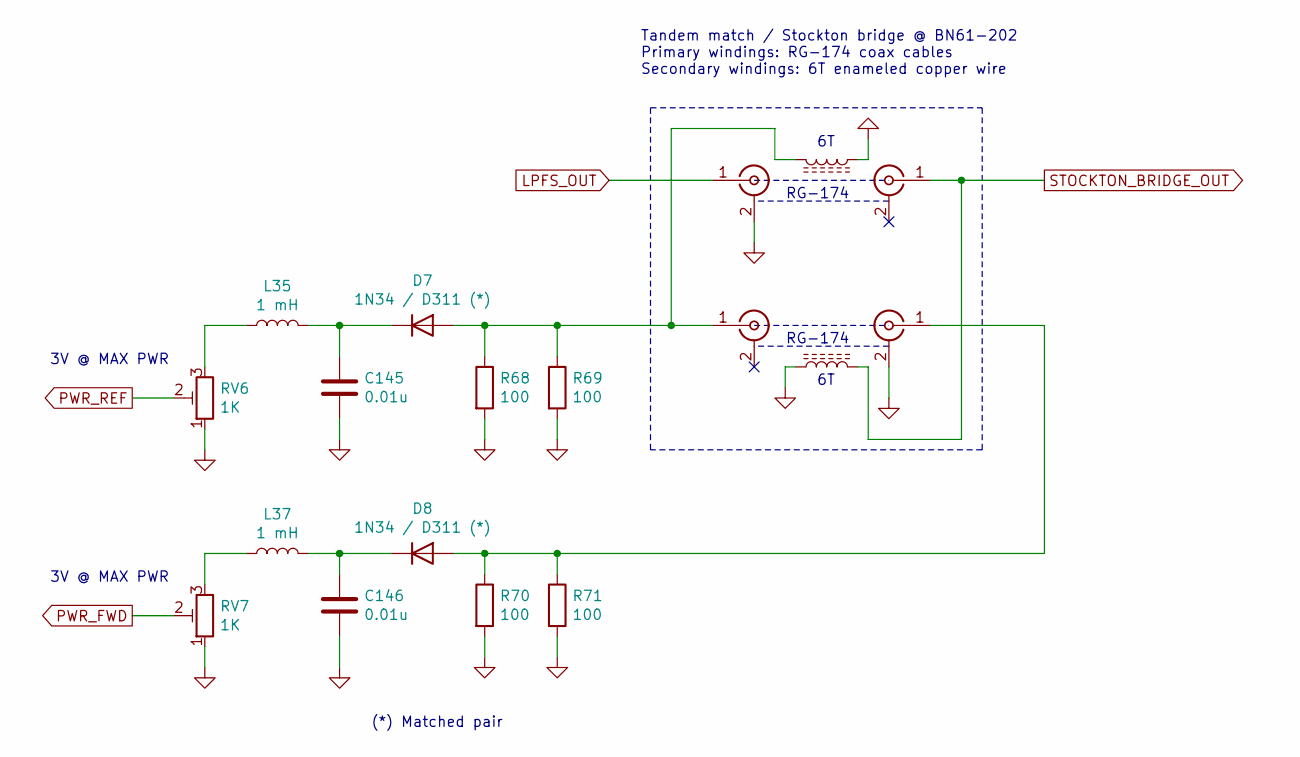
[picture p13: schematic stockton-birdge.kicad_sch]

Parts:
C145, C146: 0.01u
D7, D8: 1N34 / D311 (*)
J5, J6, J7, J8: Conn_Coaxial
L34, L36: L_Core_Ferrite
L35, L37: 1 mH
R68, R69, R70, R71: 100
RV6, RV7: 1K

Connections:
GND: C145.2, C146.2, J5.2 (Ext), J8.2 (Ext), L34.1, L36.1, R68.2, R69.2, R70.2, R71.2, RV6.1, RV7.1
LPFS_OUT: J5.1 (In)
unnamed: C145.1, D7.1 (K), L35.2
unnamed: C146.1, D8.1 (K), L37.2
unnamed: D7.2 (A), J7.1 (In), L34.2, R68.1, R69.1
unnamed: D8.2 (A), J8.1 (In), R70.1, R71.1
unnamed: L35.1, RV6.3
unnamed: L37.1, RV7.3
PWR_FWD: RV7.2
PWR_REF: RV6.2
STOCKTON_BRIDGE_OUT: J6.1 (In), L36.2

Notes on the sheet:
(*) Matched pair
Tandem match / Stockton bridge @ BN61-202 Primary windings: RG-174 coax cables Secondary windings: 6T enameled copper wire
3V @ MAX PWR
RG-174
