iu3qez/hbr-8b/schematic/converted/tx.kicad_sch

## KiCad design schematic/converted/tx.kicad_sch (2026-09-16)

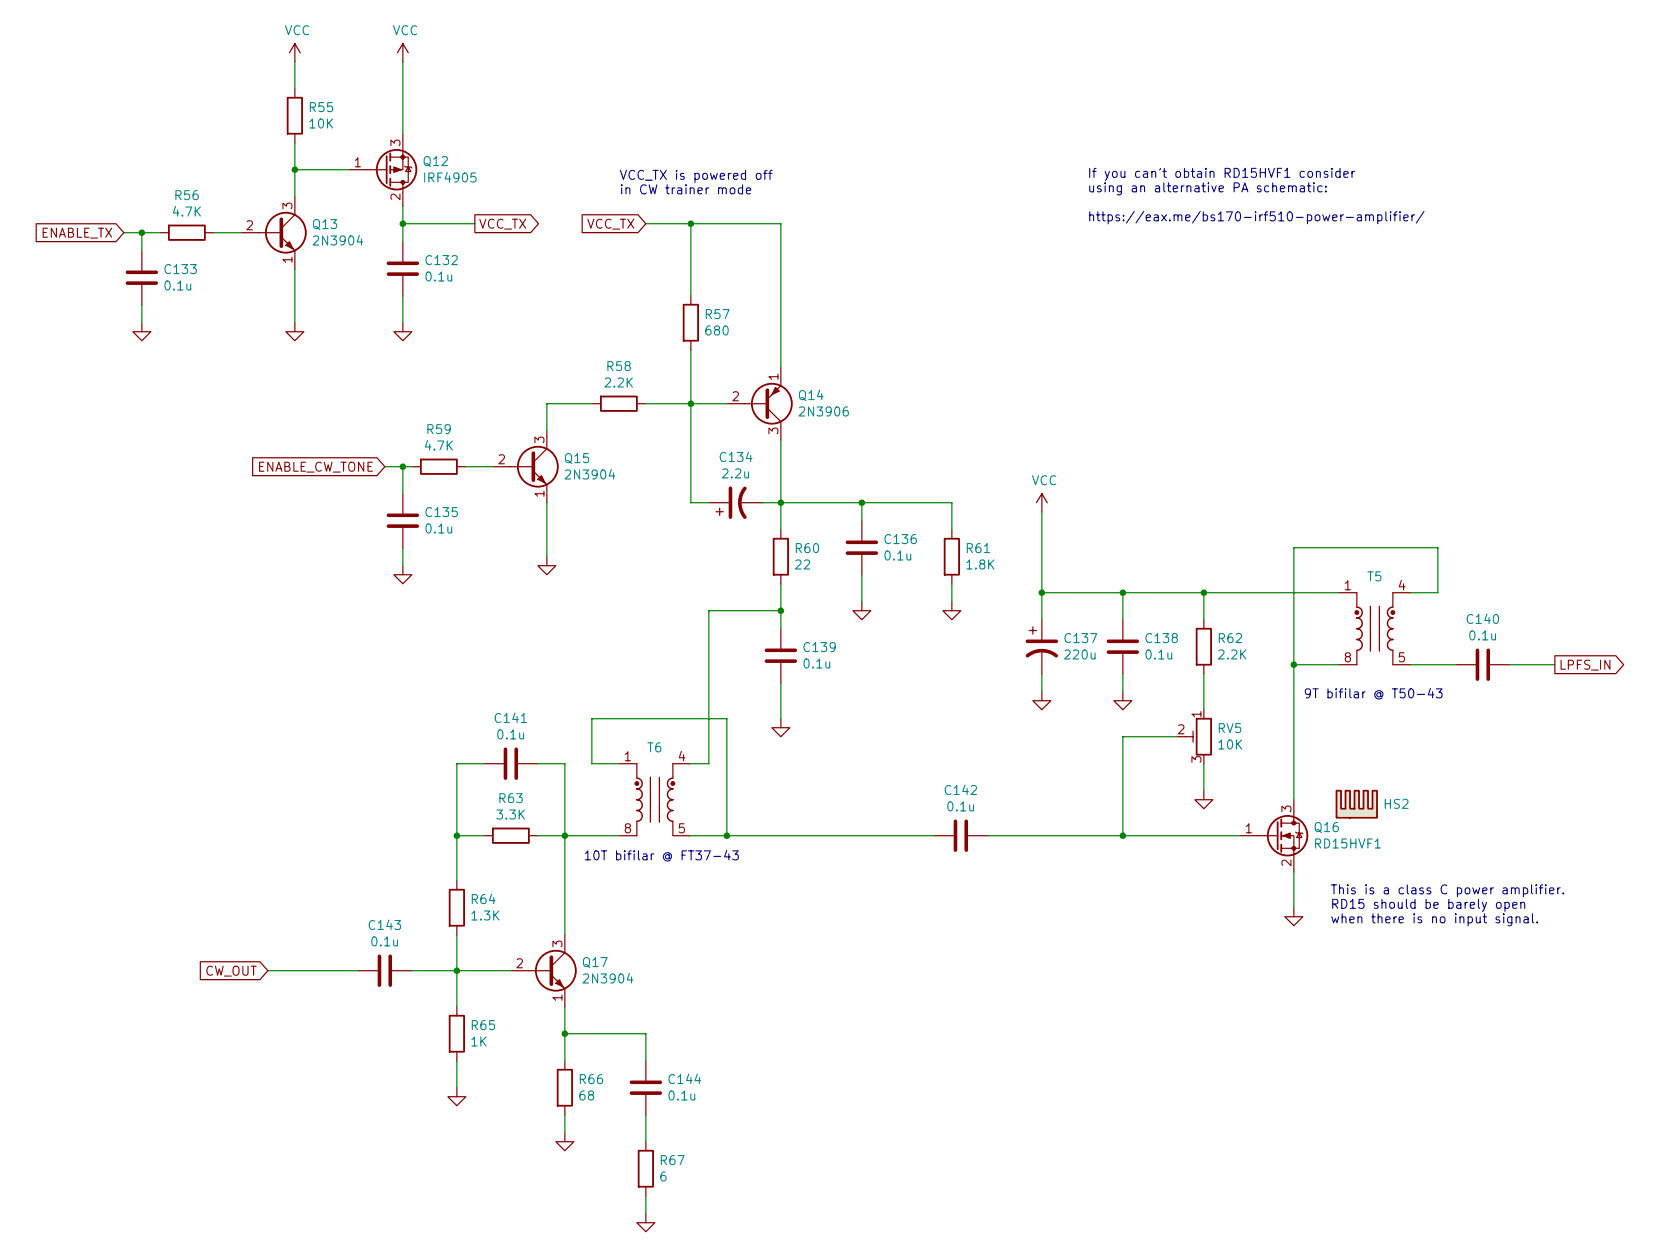
[picture p14: schematic tx.kicad_sch]

Parts:
C132, C133, C135, C136, C138, C139, C140, C141, C142, C143, C144: 0.1u
C134: 2.2u
C137: 220u
HS2: Heatsink
Q12: IRF4905; TO-220-3_Vertical
Q13, Q15, Q17: 2N3904; TO-92_Inline
Q14: 2N3906; TO-92_Inline
Q16: RD15HVF1
R55: 10K
R56, R59: 4.7K
R57: 680
R58, R62: 2.2K
R60: 22
R61: 1.8K
R63: 3.3K
R64: 1.3K
R65: 1K
R66: 68
R67: 6
RV5: 10K
T5, T6: FT37-43; Pulse_PA2007NL

Connections:
CW_OUT: C143.2
ENABLE_CW_TONE: C135.1, R59.2
ENABLE_TX: C133.1, R56.2
GND: C132.2, C133.2, C135.2, C136.2, C137.2, C138.2, C139.2, Q13.1 (E), Q15.1 (E), Q16.2 (S), R61.2, R65.2, R66.2, R67.2, RV5.3
LPFS_IN: C140.1
unnamed: C134.1, Q14.2 (B), R57.2, R58.1
unnamed: C134.2, C136.1, Q14.3 (C), R60.1, R61.1
unnamed: C139.1, R60.2, T6.4
unnamed: C140.2, T5.5
unnamed: C141.1, Q17.3 (C), R63.1, T6.8
unnamed: C141.2, R63.2, R64.1
unnamed: C142.1, Q16.1 (G), RV5.2
unnamed: C142.2, T6.1, T6.5
unnamed: C143.1, Q17.2 (B), R64.2, R65.1
unnamed: C144.1, Q17.1 (E), R66.1
unnamed: C144.2, R67.1
unnamed: Q12.1 (G), Q13.3 (C), R55.2
unnamed: Q13.2 (B), R56.1
unnamed: Q15.2 (B), R59.1
unnamed: Q15.3 (C), R58.2
unnamed: Q16.3 (D), T5.4, T5.8
unnamed: R62.2, RV5.1
VCC: C137.1, C138.1, Q12.3 (S), R55.1, R62.1, T5.1
VCC_TX: C132.1, Q12.2 (D), Q14.1 (E), R57.1

Notes on the sheet:
VCC_TX is powered off in CW trainer mode
9T bifilar @ T50-43
If you can’t obtain RD15HVF1 consider using an alternative PA schematic: https://eax.me/bs170-irf510-power-amplifier/
10T bifilar @ FT37-43
This is a class C power amplifier. RD15 should be barely open when there is no input signal.
