iu3qez/hbr-8b/(commit log)

2026-09-16 feat(zener): impalcatura del workspace e regole operative (U2)
    Workspace pcb con components/, modules/ e boards/hbr8b/ sulle convenzioni
    gia' usate in vhf-transverter. Hbr8b.zen e' lo scheletro di composizione:
    dichiara Board() e i net di confine verso i blocchi a sola interfaccia.
    CLAUDE.md raccoglie le regole che valgono da qui in avanti, comprese le due
    nuove emerse in revisione: simboli solo in formato KiCad 10, e riferimenti dei
    componenti identici allo schema annotato sui blocchi trascritti.
2026-09-16 feat(tools): confronto strutturale fra due netlist KiCadXML (U3)
    netdiff.py accoppia i componenti per riferimento e confronta i collegamenti
    ignorando i nomi dei net: nello schema upstream i nodi interni sono anonimi e
    prendono nomi autogenerati che cambiano a ogni rinumerazione.
    Il footprint resta fuori dal confronto (notazioni disgiunte fra i due lati, e
    in questa fase e' comunque provvisorio); i valori si confrontano dopo
    normalizzazione, cosi' 100n, 100nF e 0.1u sono lo stesso valore.
    Le differenze volute si dichiarano in un file di eccezioni e non fanno fallire
    l'uscita, restando pero' nel rapporto.
    11 test sui casi elencati in U3 del piano.
2026-09-16 feat(schematic): conversione annotata e netlist di riferimento (U1)
    Lo schema upstream KiCad 5 e' stato aperto in eeschema, salvato nel formato
    moderno sotto schematic/converted/ e annotato conservando i riferimenti
    esistenti: i 177 componenti che portavano il punto interrogativo ora hanno un
    riferimento stabile, che e' la chiave con cui netdiff.py accoppia i due lati.
    docs/netlist-upstream.xml e' la netlist congelata di riferimento: 441
    componenti, 359 net, nessun riferimento non annotato. Il conteggio atteso nel
    piano era 443 perche' contava i simboli: l'NE5532 del generatore di nota e' un
    doppio operazionale che compare come tre simboli ma e' un solo integrato.
    Verificato anche che BPFS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
    [bfo.kicad_sch, bpf-relays-1.kicad_sch, bpf-relays-2.kicad_sch, bpfs.kicad_sch, cw-tone.kicad_sch, extra-rx-filters.kicad_sch, hbr-8b.kicad_sch, lpf-relays.kicad_sch]
2026-09-16 chore: ignora cache della toolchain e progetti KiCad derivati
    .pcb/ sono 36 MB di dipendenze rigenerabili, come in vhf-transverter.
    boards/**/layout/ contiene i progetti KiCad che pcb apply schematic genera per
    il confronto di netlist: artefatti derivati, non sorgenti.
2026-09-16 docs(plan): pcb import non e' utilizzabile, i blocchi si scrivono a mano
    Verificato sul foglio convertito del BFO: l'importazione si ferma sul primo
    gruppo di parti che non riesce a formare. Assegnando un'impronta valida ai 64
    componenti che ne erano privi, l'errore si sposta sul gruppo dei 2N3904, la cui
    impronta non esiste nelle librerie di KiCad 10: pcb import pretende che ogni
    componente abbia un'impronta risolvibile, cioe' il layout che questa fase
    esclude.
2026-09-16 docs(strategy): le otto bande restano tutte
    Scelta di prodotto: ridurre la copertura non e' una semplificazione ammessa.
    Senza scriverlo, la proposta di tagliare bande ritorna ogni volta che si guarda
    l'ingombro dei banchi di filtri.
2026-09-16 chore: ignora i file di preferenze locali di KiCad
